fbelavenuto/colecofpga/DOCs/Cartridge/CVUNOEXP1.JPG

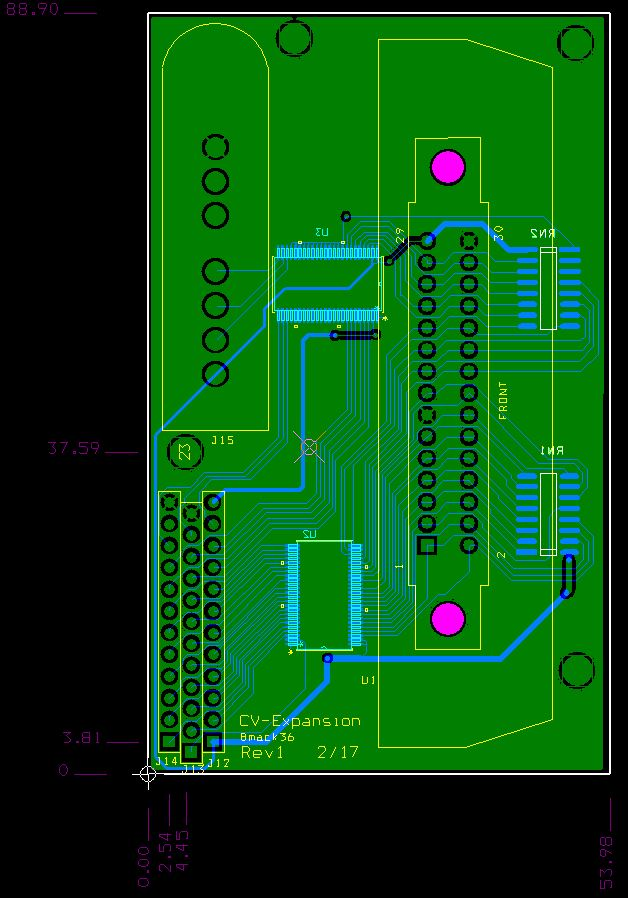
DOCs/Cartridge/CVUNOEXP1.JPG
