fbelavenuto/colecofpga/DOCs/zxuno_vga2m/SCH_VGA2M.pdf

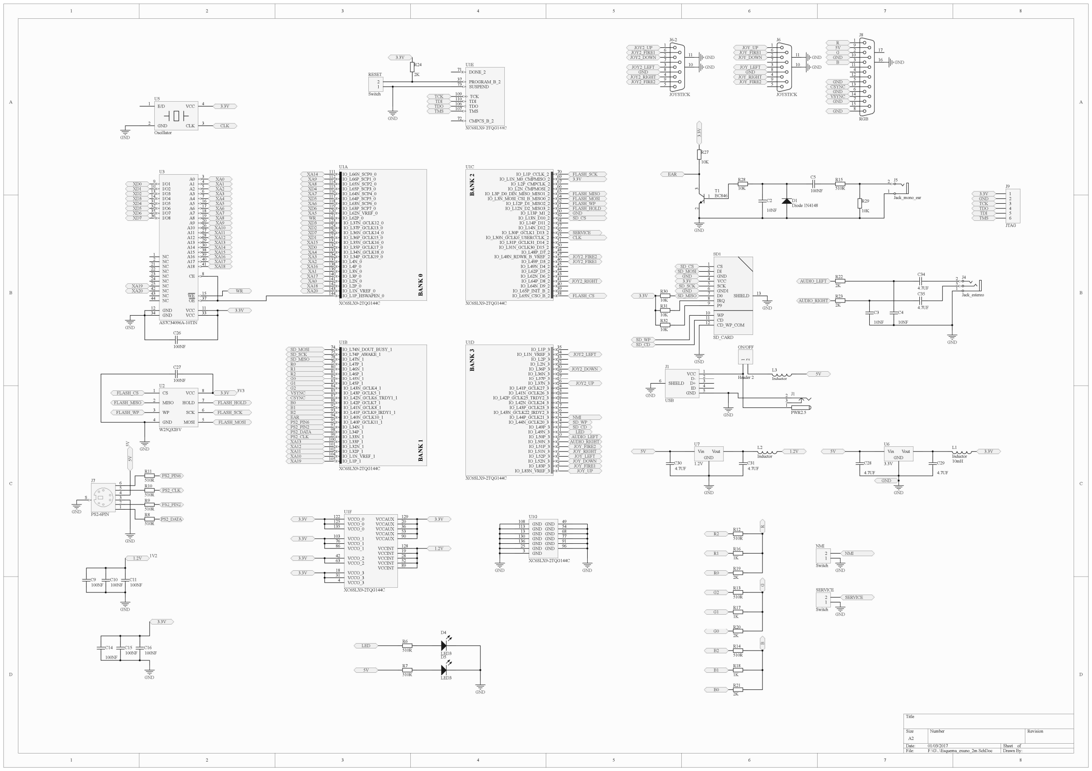
[picture p2: page 1]

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
Title

Size | Number | Revision
A2
Date: | 01/03/2017 | Sheet of
File: | F:\G\..\Esquema_zxuno_2m.SchDoc | Drawn By:
144 | IO_L1P_HSWAPEN_0 | BANK ⁰ IO_L1N_VREF_0 143 | IO_L2P_0 142 | IO_L2N_0 141 | IO_L3P_0 140 | IO_L3N_0 139 | IO_L4P_0 138 | IO_L4N_0 137 | IO_L34P_GCLK19_0 134 | IO_L34N_GCLK18_0 133 | IO_L35P_GCLK17_0 132 | IO_L35N_GCLK16_0 131 | IO_L36P_GCLK15_0 127 | IO_L36N_GCLK14_0 126 | IO_L37P_GCLK13_0 124 | IO_L37N_GCLK12_0 123 | IO_L62P_0 121 | IO_L62N_VREF_0 120 | IO_L63P_SCP7_0 119 | IO_L63N_SCP6_0 118 | IO_L64P_SCP5_0 117 | IO_L64N_SCP4_0 116 | IO_L65P_SCP3_0 115 | IO_L65N_SCP2_0 114 | IO_L66P_SCP1_0 112 | IO_L66N_SCP0_0 111

U1A

XC6SLX9-2TQG144C

105 | IO_L1P_1 | BANK ¹ IO_L1N_VREF_1 104 | IO_L32P_1 102 | IO_L32N_1 101 | IO_L33P_1 100 | IO_L33N_1 99 | IO_L34P_1 98 | IO_L34N_1 97 | IO_L40P_GCLK11_1 95 | IO_L40N_GCLK10_1 94 | IO_L41P_GCLK9_IRDY1_1 93 | IO_L41N_GCLK8_1 92 | IO_L42P_GCLK7_1 88 | IO_L42N_GCLK6_TRDY1_1 87 | IO_L43P_GCLK5_1 85 | IO_L43N_GCLK4_1 84 | IO_L45P_1 83 | IO_L45N_1 82 | IO_L46P_1 81 | IO_L46N_1 80 | IO_L47P_1 79 | IO_L47N_1 78 | IO_L74P_AWAKE_1 75 | IO_L74N_DOUT_BUSY_1 74

U1B

XC6SLX9-2TQG144C | BANK ² | IO_L1P_CCLK_2 | 70
| | IO_L1N_M0_CMPMISO_2 | 69
| | IO_L2P_CMPCLK_2 | 67
| | IO_L2N_CMPMOSI_2 | 66
| | IO_L3P_D0_DIN_MISO_MISO1_2 | 65
| | IO_L3N_MOSI_CSI_B_MISO0_2 | 64
| | IO_L12P_D1_MISO2_2 | 62
| | IO_L12N_D2_MISO3_2 | 61
| | IO_L13P_M1_2 | 60
| | IO_L13N_D10_2 | 59
| | IO_L14P_D11_2 | 58
| | IO_L14N_D12_2 | 57
| | IO_L30P_GCLK1_D13_2 | 56
| | IO_L30N_GCLK0_USERCCLK_2 | 55
| | IO_L31P_GCLK31_D14_2 | 51
| | IO_L31N_GCLK30_D15_2 | 50
| | IO_L48P_D7_2 | 48
| | IO_L48N_RDWR_B_VREF_2 | 47
| | IO_L49P_D3_2 | 46
| | IO_L49N_D4_2 | 45
| | IO_L62P_D5_2 | 44
| | IO_L62N_D6_2 | 43
| | IO_L64P_D8_2 | 41
| | IO_L64N_D9_2 | 40
| | IO_L65P_INIT_B_2 | 39
| | IO_L65N_CSO_B_2 | 38

U1C

XC6SLX9-2TQG144C BANK ³ | IO_L1P_3 | 35
IO_L1N_VREF_3 | 34
IO_L2P_3 | 33
IO_L2N_3 | 32
IO_L36P_3 | 30
IO_L36N_3 | 29
IO_L37P_3 | 27
IO_L37N_3 | 26
IO_L41P_GCLK27_3 | 24
IO_L41N_GCLK26_3 | 23
IO_L42P_GCLK25_TRDY2_3 | 22
IO_L42N_GCLK24_3 | 21
IO_L43P_GCLK23_3 | 17
IO_L43N_GCLK22_IRDY2_3 | 16
IO_L44P_GCLK21_3 | 15
IO_L44N_GCLK20_3 | 14
IO_L49P_3 | 12
IO_L49N_3 | 11
IO_L50P_3 | 10
IO_L50N_3 | 9
IO_L51P_3 | 8
IO_L51N_3 | 7
IO_L52P_3 | 6
IO_L52N_3 | 5
IO_L83P_3 | 2
IO_L83N_VREF_3 | 1

U1D

XC6SLX9-2TQG144C

PROGRAM_B_2 37

CMPCS_B_2 72

DONE_2 71

TCK 109
TDI 110
TMS 107 TDO 106

SUSPEND 73

U1E

XC6SLX9-2TQG144C

VCCAUX | 129
VCCAUX | 20
VCCAUX | 36
VCCAUX | 53
VCCAUX | 90
VCCINT | 128
VCCINT | 19
VCCINT | 28
VCCINT | 52
VCCINT | 89

VCCO_0 122
VCCO_0 125
VCCO_0 135

VCCO_1 103
VCCO_1 76
VCCO_1 86

VCCO_2 42
VCCO_2 63

VCCO_3 18
VCCO_3 31
VCCO_3 4

U1F

XC6SLX9-2TQG144C

GND 108
GND 113
GND 13
GND 130
GND 136
GND 25
GND 3
GND | 49
GND | 54
GND | 68
GND | 77
GND | 91
GND | 96

U1G

XC6SLX9-2TQG144C

A15 | 38 A14 | 30 A13 | 29 A12 | 28 A11 | 27 A10 | 26 A9 | 20 A8 | 19
WE | 15
A17 | 40
A7 | 18 A6 | 17 A5 | 16 A4 | 7
A3 | 6
A2 | 5
A1 | 4
A0 | 3
VCC | 33 GND 12
OE | 37

NC 21

I/O1 9

NC 22

I/O2 10

NC 23

I/O3 13

NC 24

I/O4 14

NC 25

I/O5 31

NC 42

I/O6 32

NC 43

I/O7 35

NC 44

GND 34

A16 | 39
VCC | 11
A18 | 41 NC 2

NC 1

CE 8

I/O8 36

U3

AS7C34096A-10TIN

E/D 1

GND 2

VCC | 4
CLK | 3

U5

Oscillator

Vin Vout
GND

U6

3.3V

Vin Vout
GND

U7

1.2V

2

1

5

J4

Jack_estereo

2

1

J5

Jack_mono_ear

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
JOYSTICK

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
PS2-6PIN

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
JTAG 1

2

ON/OFF

Header 2

1

2

RESET

Switch

D1
Diode 1N4148

D4

LED3
D5

LED3

3
1 2

T1
BC846

10mH

L1

Inductor

L2

Inductor

L3

Inductor

510R

R6

510R

R7

510R

R8

510R

R9

510R

R10

510R

R11

510R

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
10NF

C2

10NF

C3

10NF

C4

100NF

C11

100NF

C14

100NF

C26

100NF

C27

100NF

C5

100NF

C9
100NF

C10

4.7UF

C28

4.7UF

C29
4.7UF

C30
4.7UF

C31

4.7UF

C34

4.7UF

C35

FLASH_SCK

FLASH_SCK

3.3V

FLASH_MISO
FLASH_MOSI
FLASH_WP
FLASH_HOLD
GND
SD_CS

CLK

FLASH_CS

SD_MOSI
SD_SCK
SD_MISO
R0
R1
R2
G0
G1
G2
VSYNC
CSYNC
B0
B1
B2
EAR
PS2_PIN6
PS2_PIN2
PS2_DATA
PS2_CLK
XA13
XA12
XA11
XA10
XA19

XA14
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
XA15
XD0
XA4
XA3
XA2
XA16
XA1
XA17
XA0
XA18
WR | XA20

3.3V

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
XA10
XA11
XA12
XA13
XA14
XA15
XA16
XA17
XA18

XA19
XA20

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
3.3V

GND

3.3V

GND

CLK

3.3V

3.3V

GND

3.3V

3.3V

FLASH_CS

FLASH_MISO

FLASH_WP

FLASH_HOLD

FLASH_MOSI

3.3V

GND

PS2_PIN6

PS2_CLK

PS2_PIN2

PS2_DATA ⁵V

GND

1.2V

GND

100NF

C15
100NF

C16

3.3V

GND

3.3V

LED
AUDIO_LEFT
AUDIO_RIGHT
JOY_FIRE2
JOY_RIGHT
JOY_LEFT
JOY_DOWN
JOY_FIRE1
JOY_UP

1.2V

GND | GND

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
5V | 1.2V

GND

5V | 3.3V

3.3V
GND
TCK
TDO
TDI
TMS

JOY_UP

JOY_DOWN

JOY_LEFT

JOY_RIGHT

JOY_FIRE1

GND

JOY_FIRE2

SD_CS
SD_MOSI
GND
3.3V
SD_SCK
GND
3.3V | SD_MISO

GND

GND

5V

AUDIO_LEFT

AUDIO_RIGHT

GND ³.3V

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
VSYNC

CSYNC

5V

CS 1

MISO 2

WP 3

GND 4

VCC | 8
HOLD | 7
SCK | 6
MOSI | 5

U2

W25Q32BV

VCC | 1
D- | 2
D+ | 3
ID | 4
GND | 5

SHIELD 6

J1

USB

CS 1
DI 2
GND 3
VCC 4
SCK 5
GND1 6
D0 7
IRQ 8
P9 9

WP 10
CD 11
CD_WP_COM 12

SHIELD 13

SD1

SD_CARD

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
J6-2

JOYSTICK

1

2
3

J1

PWR2.5

510R

R12

510R

R13

510R

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
R G B

3V3 5V

1V2

GND

JOY2_UP
JOY2_FIRE1
JOY2_DOWN

JOY2_LEFT
GND
JOY2_RIGHT
JOY2_FIRE2

JOY2_UP

JOY2_FIRE1

JOY2_DOWN

JOY2_LEFT

JOY2_RIGHT

JOY2_FIRE2

1

2

NMI

Switch

1

2

SERVICE

Switch

NMI

NMI

GND

GND

SERVICE

SERVICE

SD_WP
SD_CD

SD_WP
SD_CD

GND

GND

GND

GND

GND

GND

GND
