fbelavenuto/colecofpga/DOCs/BIOS screen.png

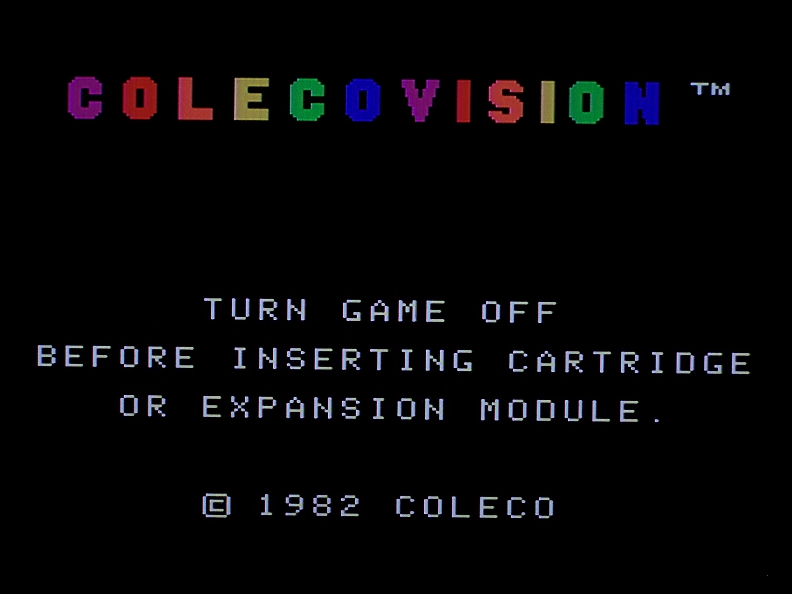
DOCs/BIOS screen.png
