fbelavenuto/colecofpga/DOCs/Cartridge/Cartridge_pinout.png

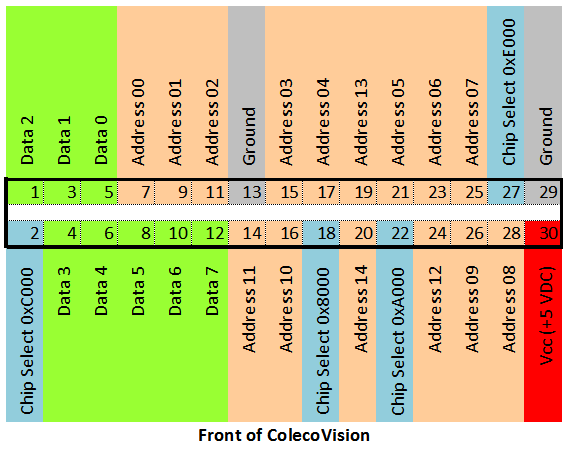
DOCs/Cartridge/Cartridge_pinout.png
