fbelavenuto/colecofpga/DOCs/ColecoController.jpg

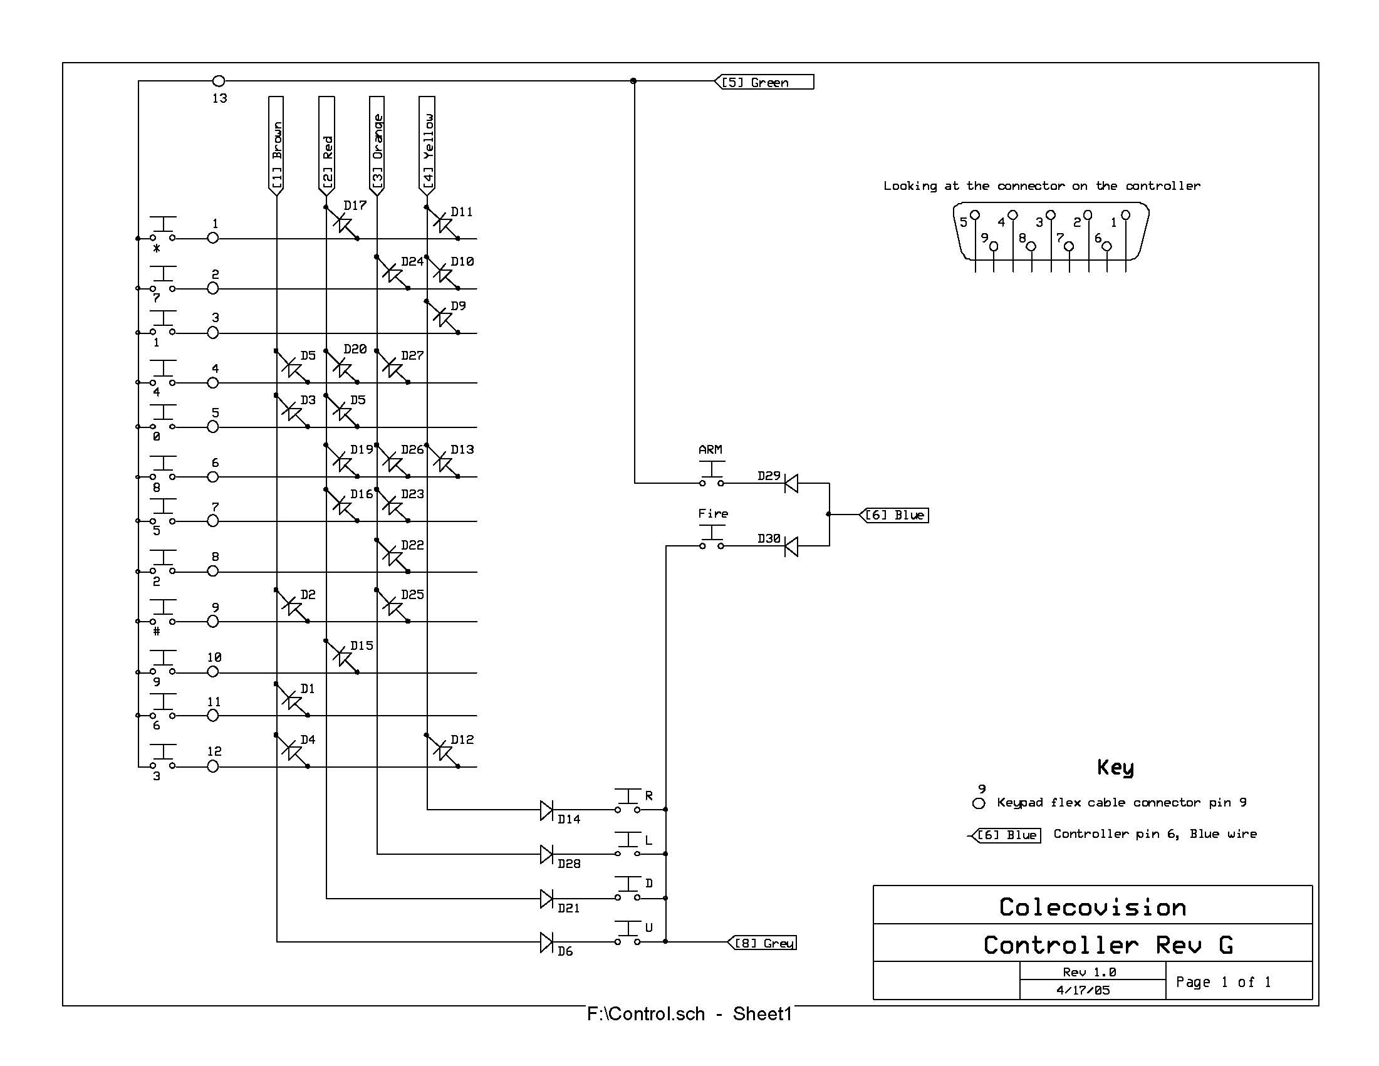
DOCs/ColecoController.jpg
