fbelavenuto/colecofpga/DOCs/SegaPad.png

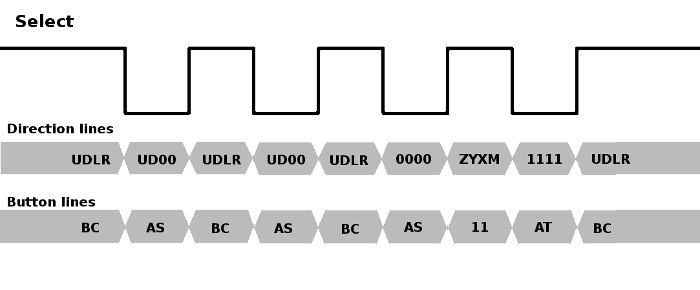
DOCs/SegaPad.png
