fbelavenuto/colecofpga/Hardware/prot2/Support/Components Map(bottom).png

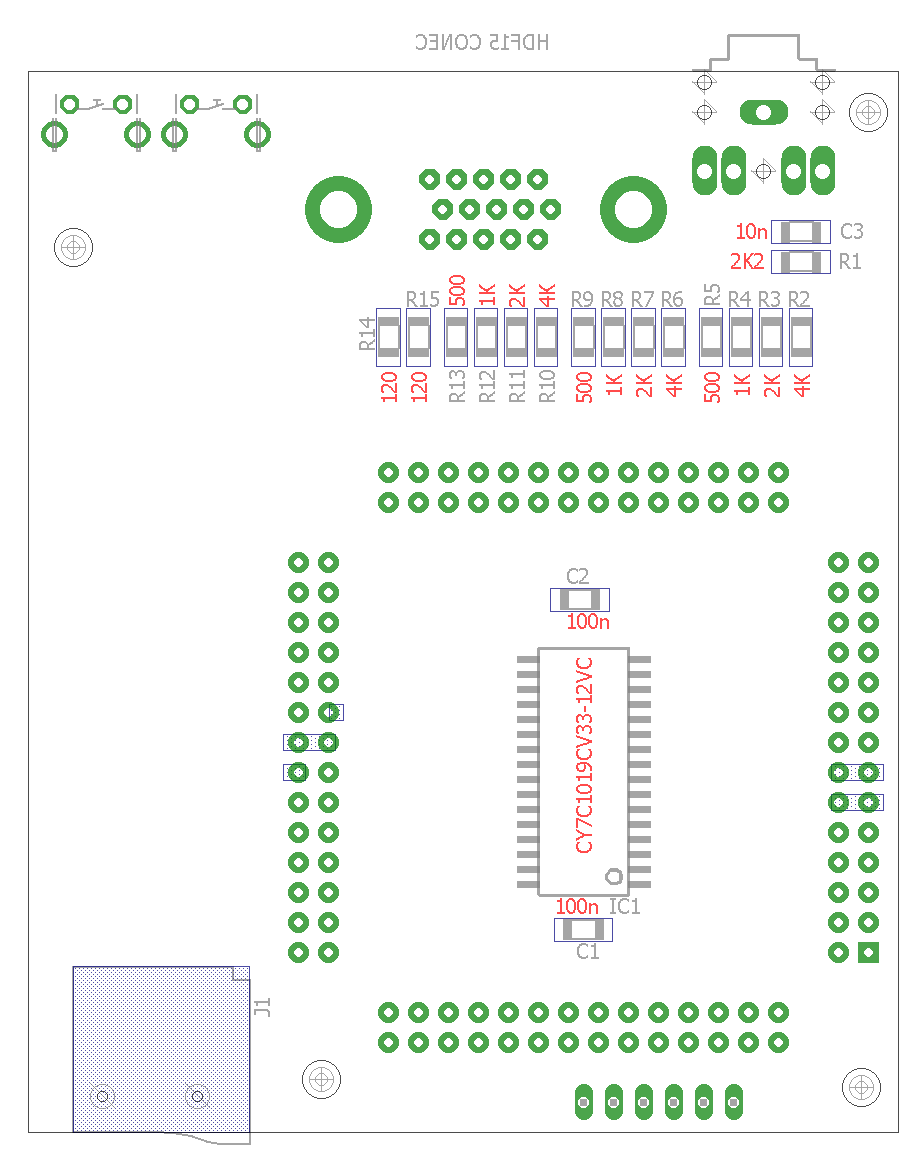
Hardware/prot2/Support/Components Map(bottom).png
