fbelavenuto/colecofpga/Hardware/prot2/Support/Components Map(top).png

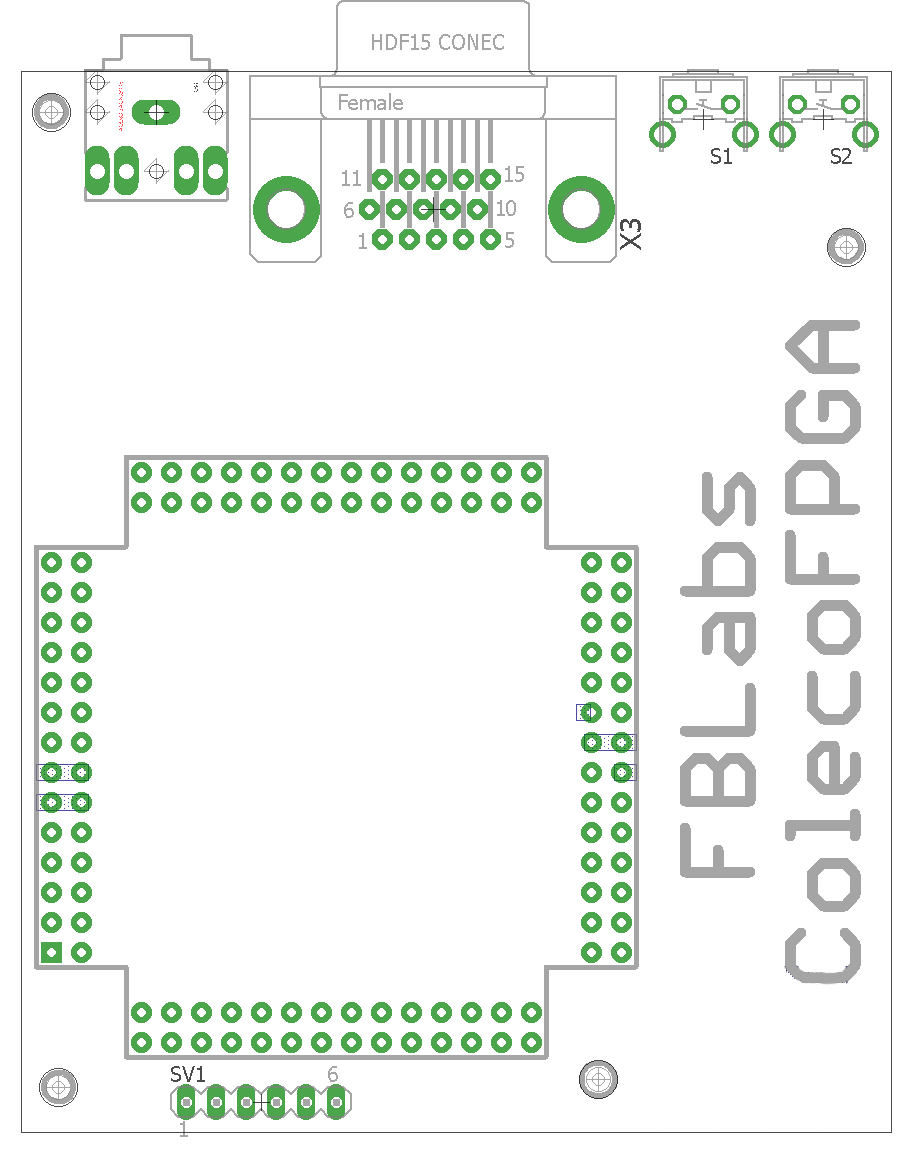
Hardware/prot2/Support/Components Map(top).png
