fbelavenuto/colecofpga/(threads)

Thread 2 (2018-11-06):

Bug in the Noise Generator (FABF)

fbelavenuto, 2018-11-06:
I’ve found a bug in the ColecoFPGA using my friend homebrew game : “battle of hoth”
https://www.youtube.com/watch?v=SUFYieaRjvY

The noise generator seem not working and “use the force” is not played.
To help debuging he provide me a rom file playing “use the force” all the time.

It would be great if you could fixe this issue because lot of hombrew use the noise generator.

Regards
Fabrice

Thread 3 (2022-06-14):

cannot compile multicrt rom

rampa069, 2022-06-14:
I am doing some changes to the coleco FPGA core (changes SN, added AY and 32Kram for SGM, etc)

 I want to recompile the rom (need to silence AY on boot) but seems there are problems compiling.

 Whith modern sdcc (4.2.0)  i have added --sdcccall 0 to makefile and the cartridge boots. but cannot mount the SD. are the sources the same version as the .rom file? if they are the same, do you remember which sdcc version you used to compile?

Thanks in advance!

rampa069, 2022-06-14:
found it. it works with 3.8.0....

Closed 2022-06-14.
