fbelavenuto/colecofpga/DOCs/colecovision.pdf

1

2

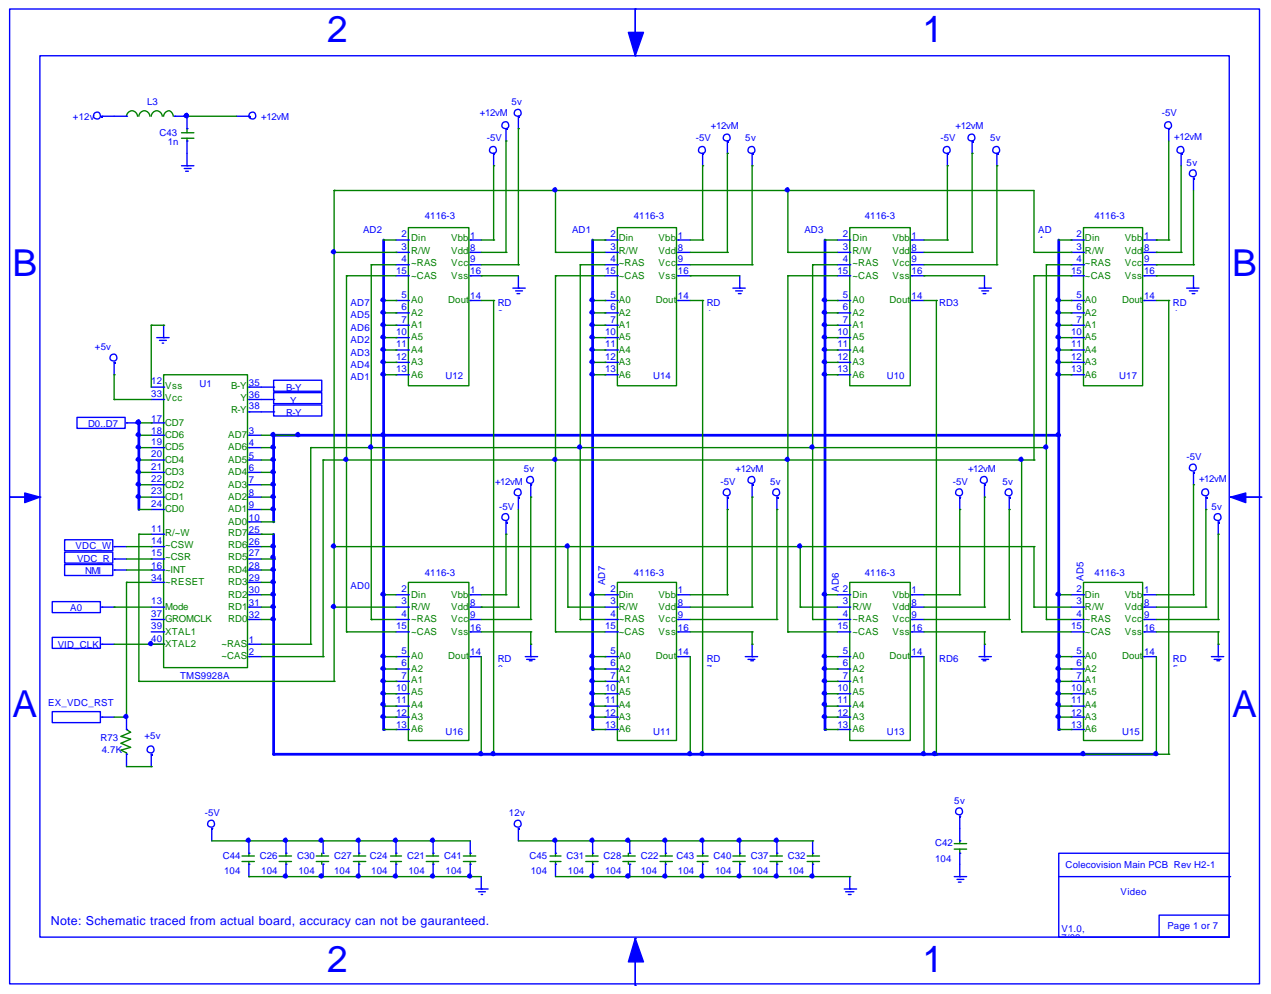
[picture p9: page 1]

Colecovision Main PCB Rev H2-1

1

2

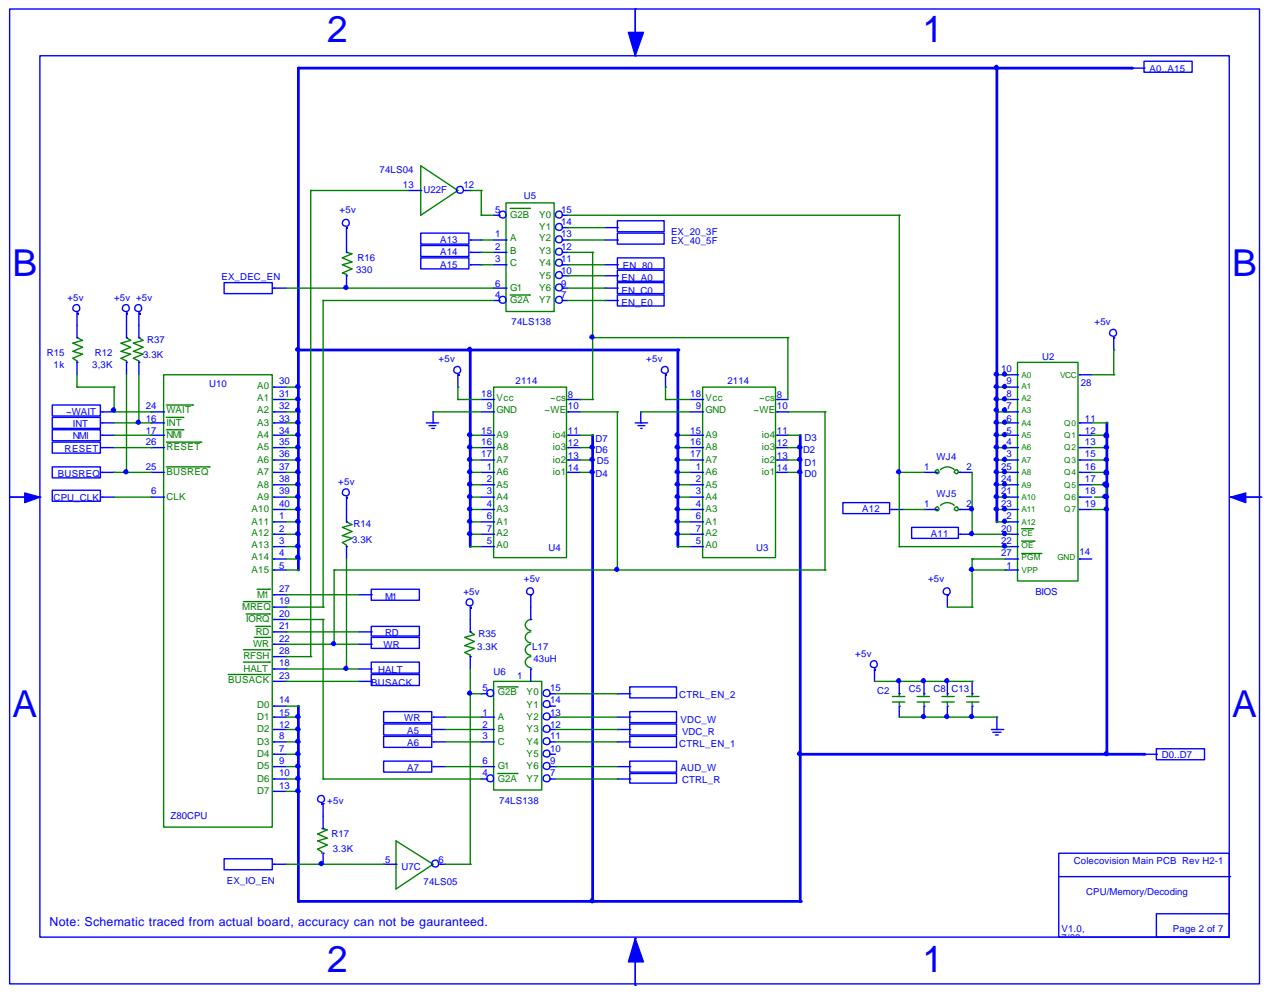
[picture p10: page 2]

Colecovision Main PCB Rev H2-1

1

2

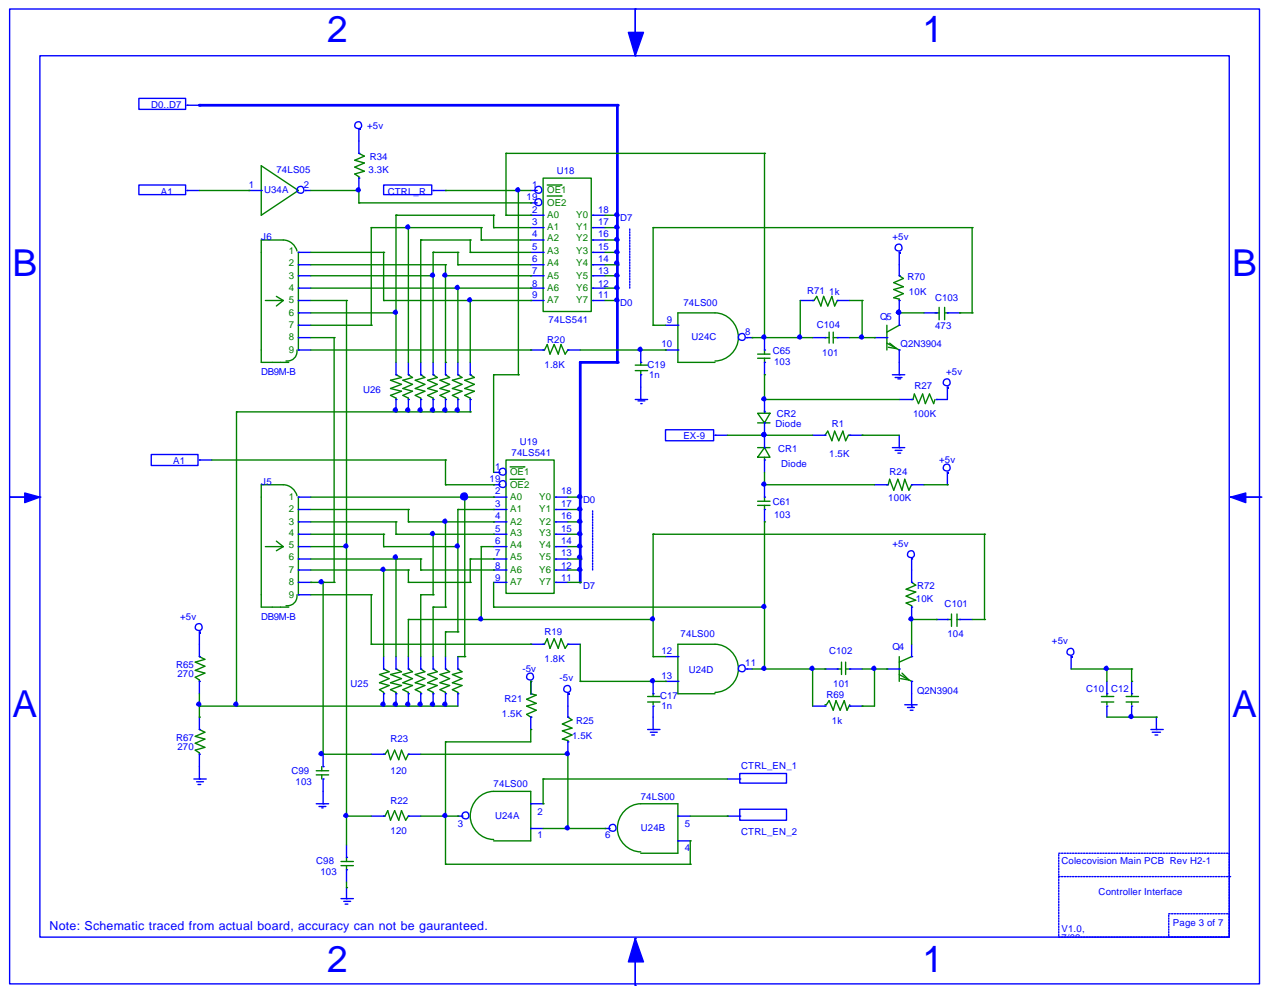
[picture p11: page 3]

Colecovision Main PCB Rev H2-1

Note: Schematic traced from actual board, accuracy can not be gauranteed.

1

2

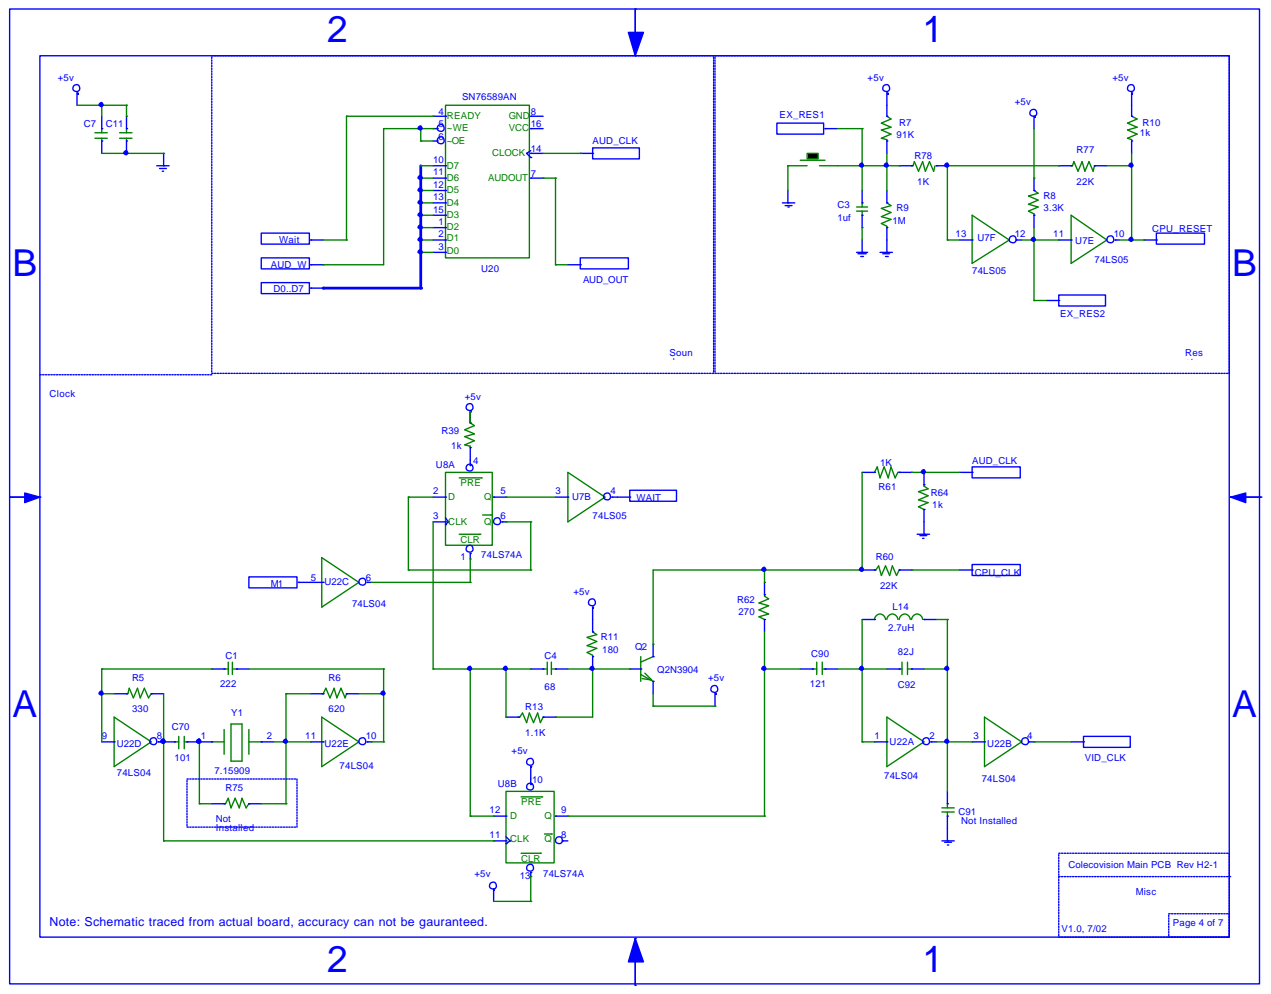
[picture p12: page 4]

Colecovision Main PCB Rev H2-1

1

2

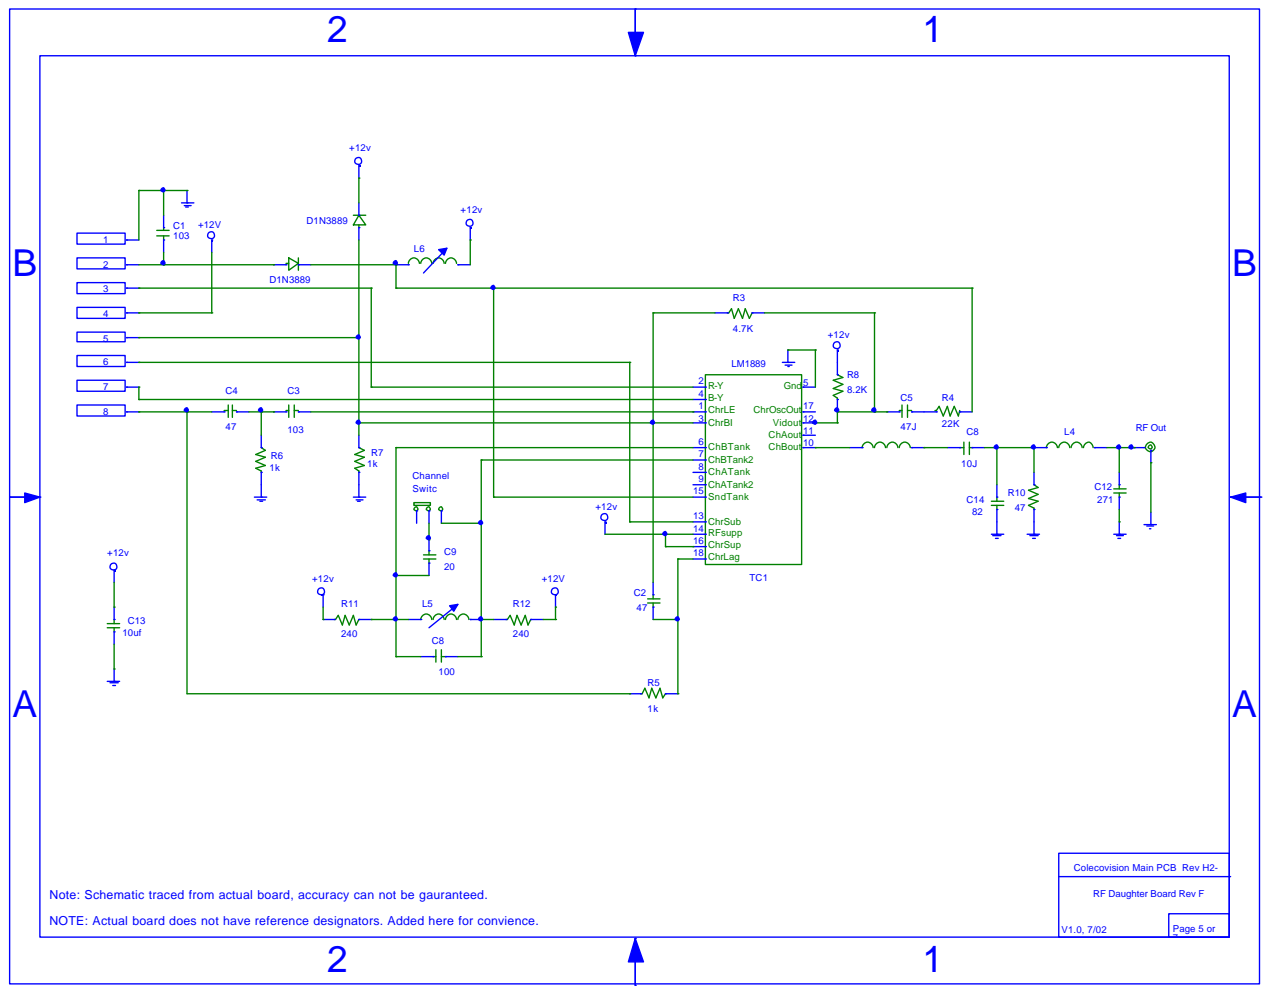
[picture p13: page 5]

Colecovision Main PCB Rev H2-
RF Daughter Board Rev F

Note: Schematic traced from actual board, accuracy can not be gauranteed.

NOTE: Actual board does not have reference designators. Added here for convience.

1

2

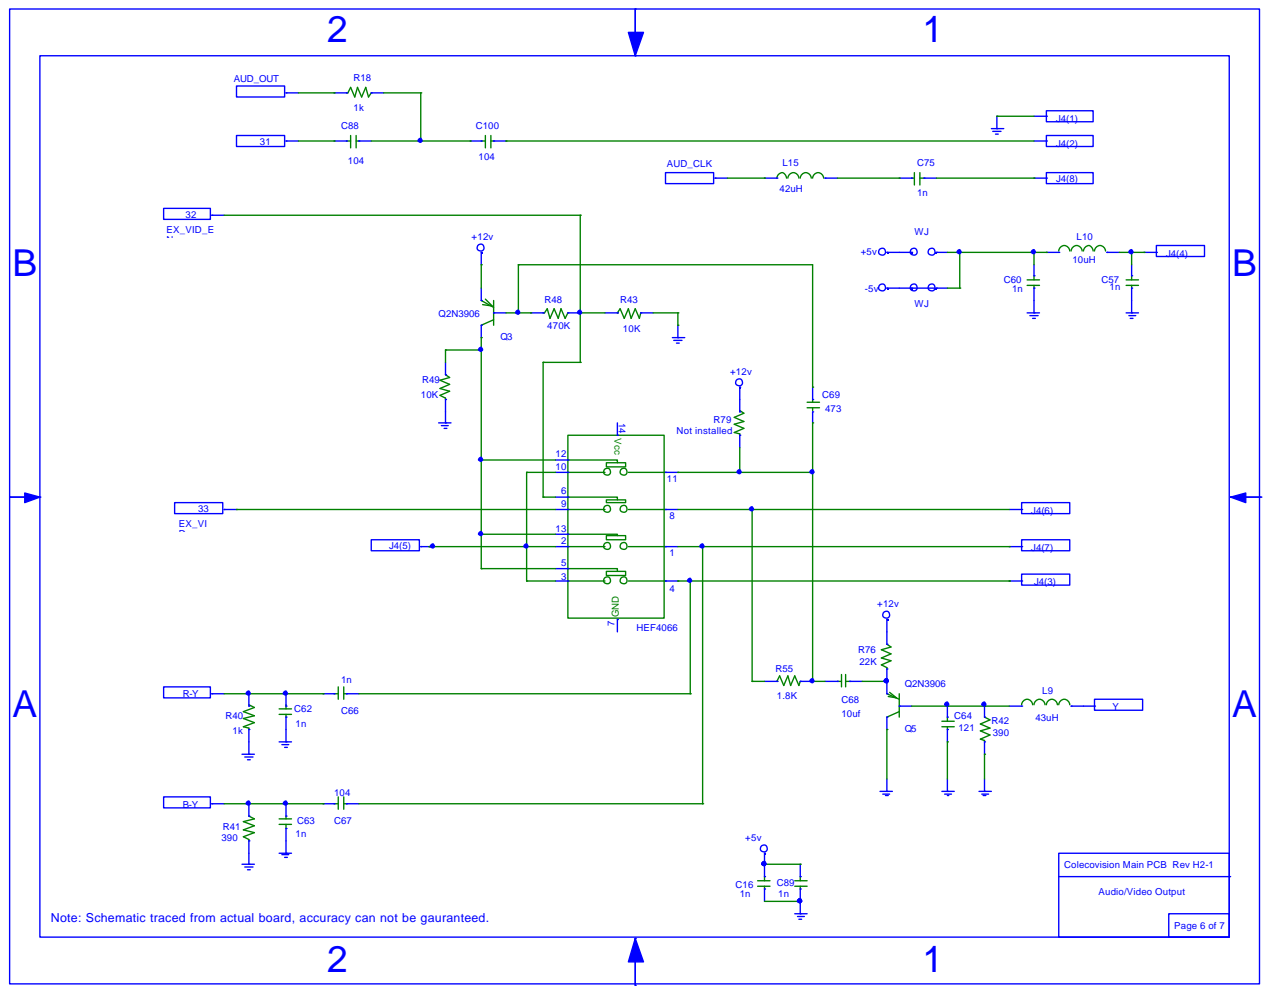
[picture p14: page 6]

Colecovision Main PCB Rev H2-1

Note: Schematic traced from actual board, accuracy can not be gauranteed.

1

2

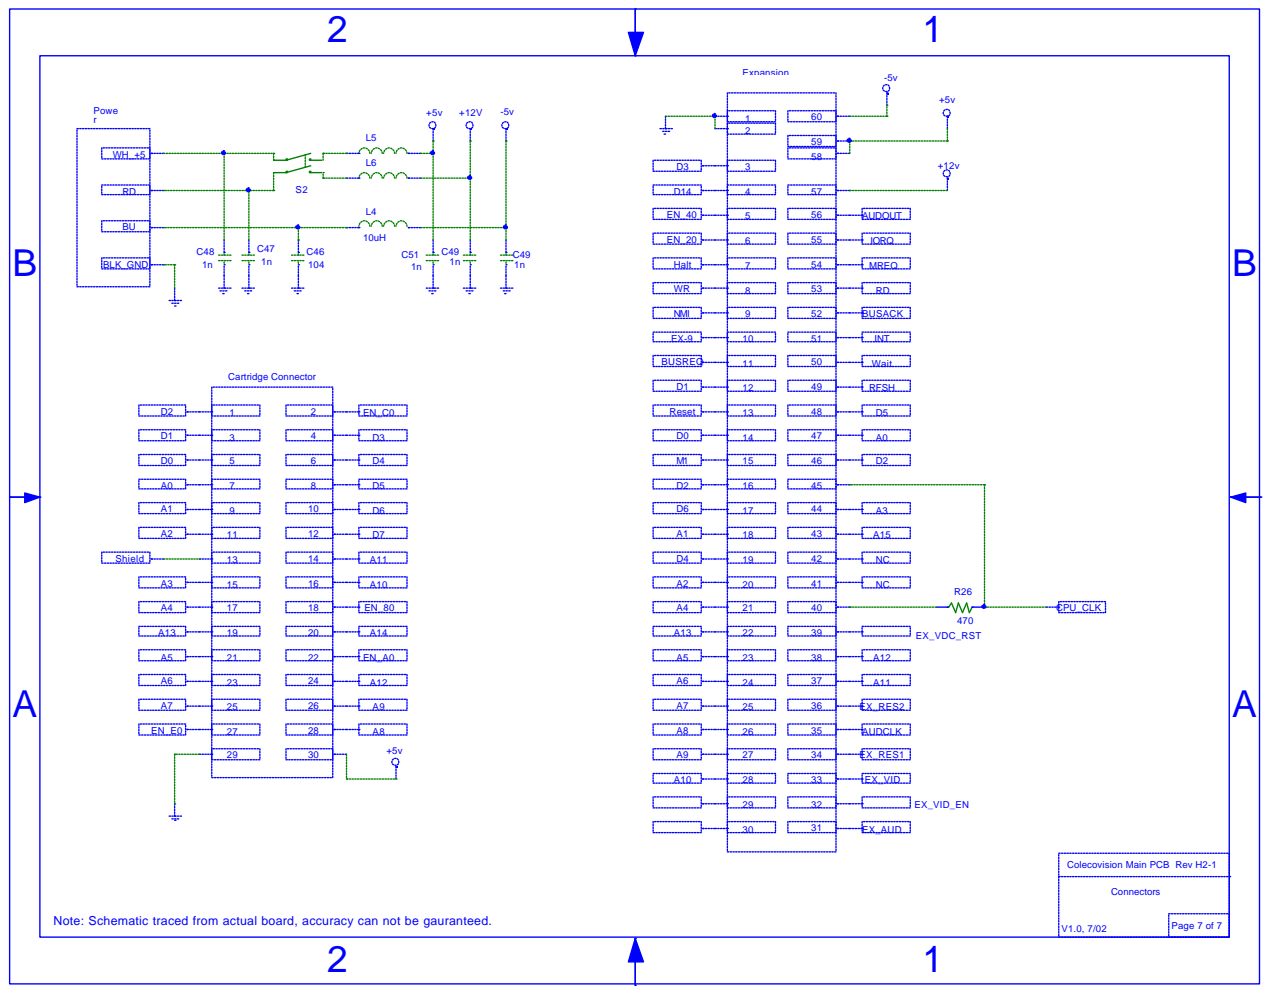
[picture p15: page 7]

Colecovision Main PCB Rev H2-1
