fbelavenuto/colecofpga/Hardware/prot2/Eagle/colecovision2.brd

## EAGLE design Hardware/prot2/Eagle/colecovision2.brd (2016-09-15)

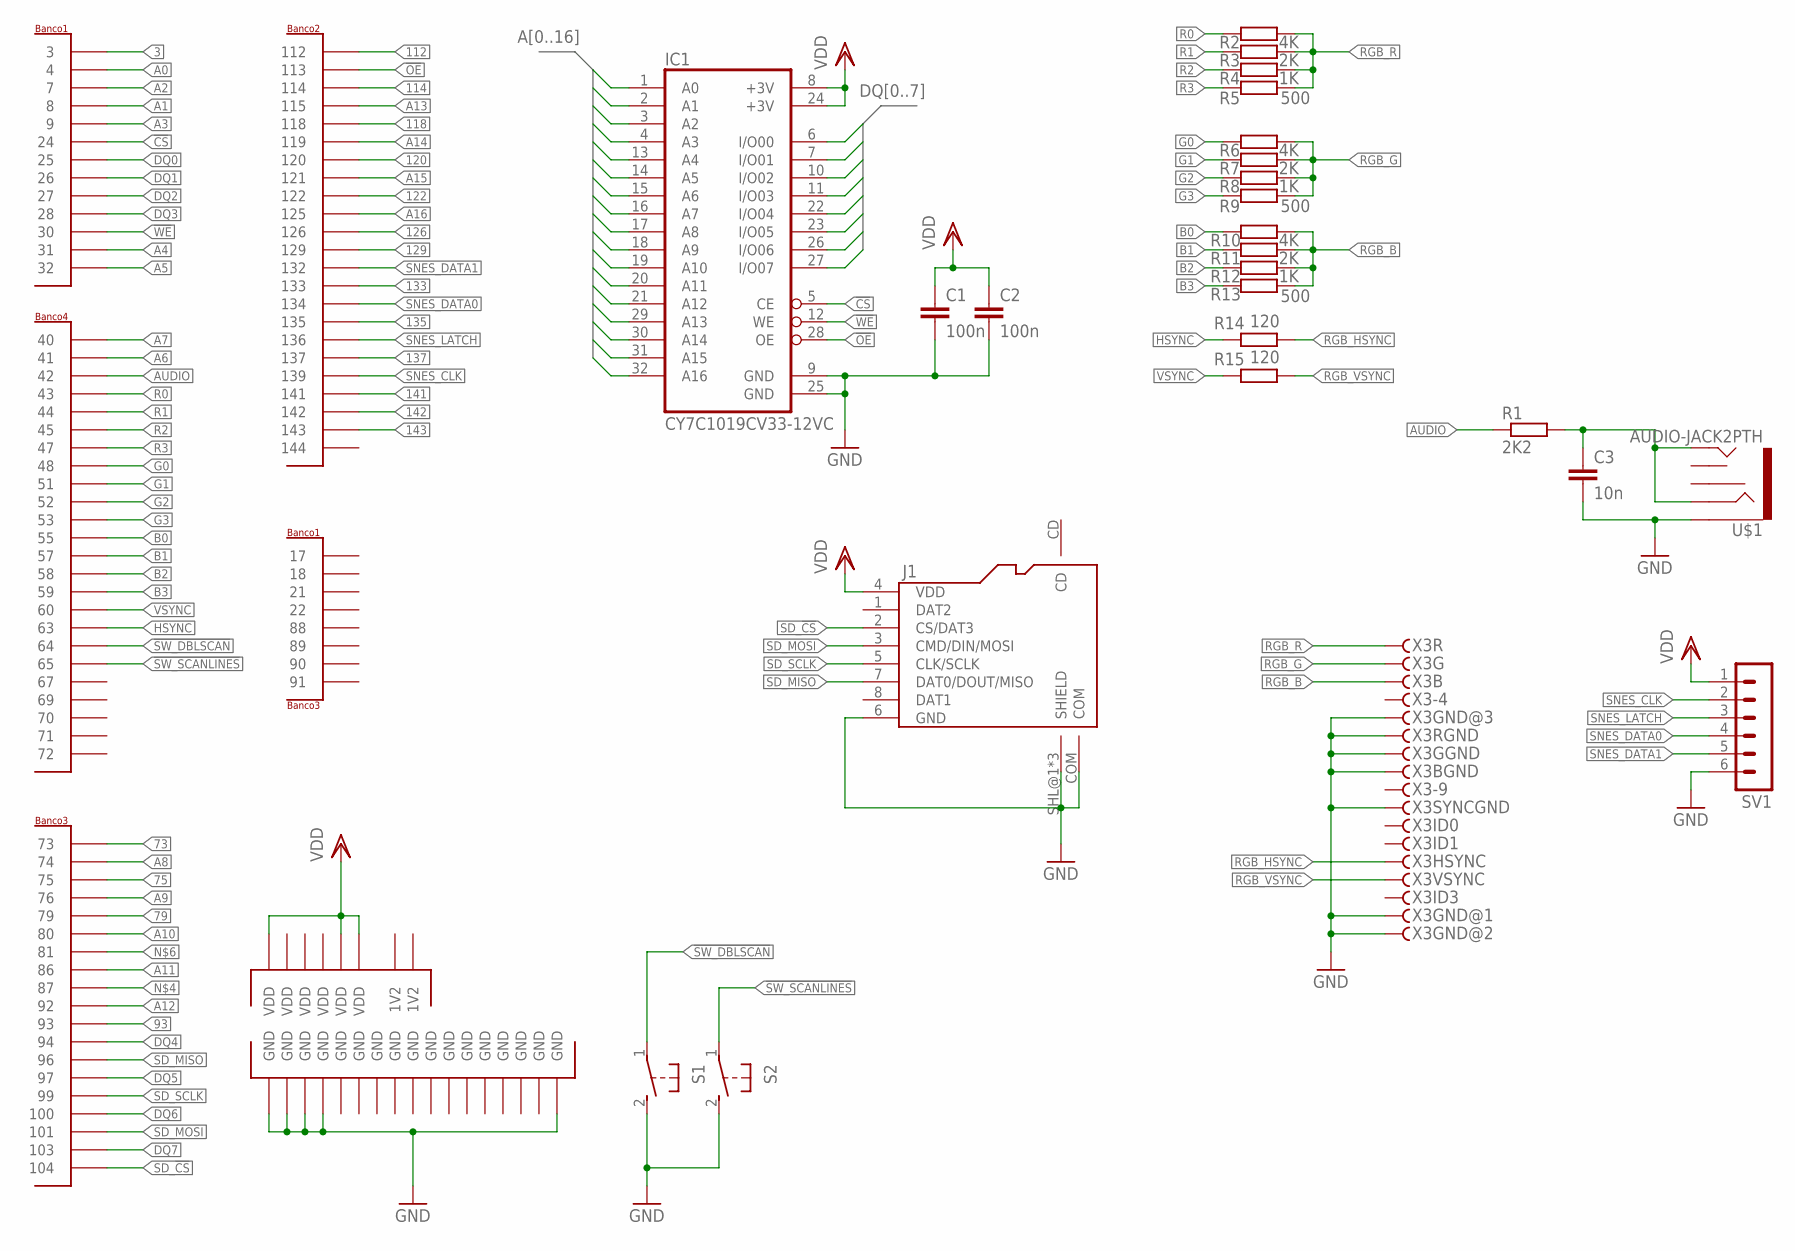
[picture p16: schematic colecovision2.sch]

Parts:
C1, C2: 100n; C1206
C3: 10n; C1206
IC1: CY7C1019CV33-12VC; SOJ32-400
J1: MICROSD-9P; 9P-SMD-W/-RING
PLC1: PLACAEP2C5LASER; 4X28_LASER
R1: 2K2; R1206
R2, R6, R10: 4K; R1206
R3, R7, R11: 2K; R1206
R4, R8, R12: 1K; R1206
R5, R9, R13: 500; R1206
R14, R15: 120; R1206
S1, S2: 31-XX; B3F-31XX
SV1: MA06-1
U$1: AUDIO-JACK2PTH; AUDIO-JACK
X3: VGAH; HDF15H

Connections:
1V2: PLC1.P$19 (1V2), PLC1.P$20 (1V2)
3: PLC1.P$3 (3)
73: PLC1.P$59 (73)
75: PLC1.P$61 (75)
79: PLC1.P$63 (79)
93: PLC1.P$73 (93)
112: PLC1.P$87 (112)
114: PLC1.P$89 (114)
118: PLC1.P$91 (118)
120: PLC1.P$93 (120)
122: PLC1.P$95 (122)
126: PLC1.P$97 (126)
129: PLC1.P$98 (129)
133: PLC1.P$100 (133)
135: PLC1.P$102 (135)
137: PLC1.P$104 (137)
141: PLC1.P$106 (141)
142: PLC1.P$107 (142)
143: PLC1.P$108 (143)
!CS: IC1.5 (CE), PLC1.P$16 (24)
!OE: IC1.28 (OE), PLC1.P$88 (113)
!SW_DBLSCAN: PLC1.P$46 (64), S1.1
!SW_SCANLINES: PLC1.P$47 (65), S2.1
!WE: IC1.12 (WE), PLC1.P$21 (30)
A0: IC1.1 (A0), PLC1.P$4 (4)
A1: IC1.2 (A1), PLC1.P$6 (8)
A2: IC1.3 (A2), PLC1.P$5 (7)
A3: IC1.4 (A3), PLC1.P$7 (9)
A4: IC1.13 (A4), PLC1.P$24 (31)
A5: IC1.14 (A5), PLC1.P$23 (32)
A6: IC1.15 (A6), PLC1.P$30 (41)
A7: IC1.16 (A7), PLC1.P$29 (40)
A8: IC1.17 (A8), PLC1.P$60 (74)
A9: IC1.18 (A9), PLC1.P$62 (76)
A10: IC1.19 (A10), PLC1.P$64 (80)
A11: IC1.20 (A11), PLC1.P$66 (86)
A12: IC1.21 (A12), PLC1.P$72 (92)
A13: IC1.29 (A13), PLC1.P$90 (115)
A14: IC1.30 (A14), PLC1.P$92 (119)
A15: IC1.31 (A15), PLC1.P$94 (121)
A16: IC1.32 (A16), PLC1.P$96 (125)
AUDIO: PLC1.P$31 (42), R1.1
B0: PLC1.P$40 (55), R10.1
B1: PLC1.P$41 (57), R11.1
B2: PLC1.P$42 (58), R12.1
B3: PLC1.P$43 (59), R13.1
DQ0: IC1.6 (I/O00), PLC1.P$15 (25)
DQ1: IC1.7 (I/O01), PLC1.P$18 (26)
DQ2: IC1.10 (I/O02), PLC1.P$17 (27)
DQ3: IC1.11 (I/O03), PLC1.P$22 (28)
DQ4: IC1.22 (I/O04), PLC1.P$74 (94)
DQ5: IC1.23 (I/O05), PLC1.P$76 (97)
DQ6: IC1.26 (I/O06), PLC1.P$78 (100)
DQ7: IC1.27 (I/O07), PLC1.P$80 (103)
G0: PLC1.P$36 (48), R6.1
G1: PLC1.P$37 (51), R7.1
G2: PLC1.P$38 (52), R8.1
G3: PLC1.P$39 (53), R9.1
GND: C1.2, C2.2, C3.2, IC1.9 (GND), IC1.25 (GND), J1.6 (GND), J1.COM, J1.SHL@1 (SHIELD), J1.SHL@2 (SHIELD), J1.SHL@3 (SHIELD), PLC1.P$1 (GND), PLC1.P$2 (GND), PLC1.P$8 (GND), PLC1.P$9 (GND), PLC1.P$10 (GND), PLC1.P$25 (GND), PLC1.P$26 (GND), PLC1.P$53 (GND), PLC1.P$54 (GND), PLC1.P$57 (GND), PLC1.P$58 (GND), PLC1.P$82 (GND), PLC1.P$83 (GND), PLC1.P$85 (GND), PLC1.P$86 (GND), PLC1.P$110 (GND), PLC1.P$111 (GND), S1.2 (S), S2.2 (S), SV1.6, U$1.SLEEVE, X3.5, X3.6, X3.7, X3.8, X3.10, X3.GND@1, X3.GND@2
HSYNC: PLC1.P$45 (63), R14.1
unnamed: C3.1, R1.2, U$1.RING, U$1.TIP
R0: PLC1.P$32 (43), R2.1
R1: PLC1.P$33 (44), R3.1
R2: PLC1.P$34 (45), R4.1
R3: PLC1.P$35 (47), R5.1
RGB_B: R10.2, R11.2, R12.2, R13.2, X3.3
RGB_G: R6.2, R7.2, R8.2, R9.2, X3.2
RGB_HSYNC: R14.2, X3.13
RGB_R: R2.2, R3.2, R4.2, R5.2, X3.1
RGB_VSYNC: R15.2, X3.14
SD_!CS: J1.2 (CS/DAT3), PLC1.P$81 (104)
SD_MISO: J1.7 (DAT0/DOUT/MISO), PLC1.P$75 (96)
SD_MOSI: J1.3 (CMD/DIN/MOSI), PLC1.P$79 (101)
SD_SCLK: J1.5 (CLK/SCLK), PLC1.P$77 (99)
SNES_CLK: PLC1.P$105 (139), SV1.2
SNES_DATA0: PLC1.P$101 (134), SV1.4
SNES_DATA1: PLC1.P$99 (132), SV1.5
SNES_LATCH: PLC1.P$103 (136), SV1.3
VDD: C1.1, C2.1, IC1.8 (+3V), IC1.24 (+3V), J1.4 (VDD), PLC1.P$27 (VDD), PLC1.P$28 (VDD), PLC1.P$55 (VDD), PLC1.P$56 (VDD), PLC1.P$84 (VDD), PLC1.P$112 (VDD), SV1.1
VSYNC: PLC1.P$44 (60), R15.1

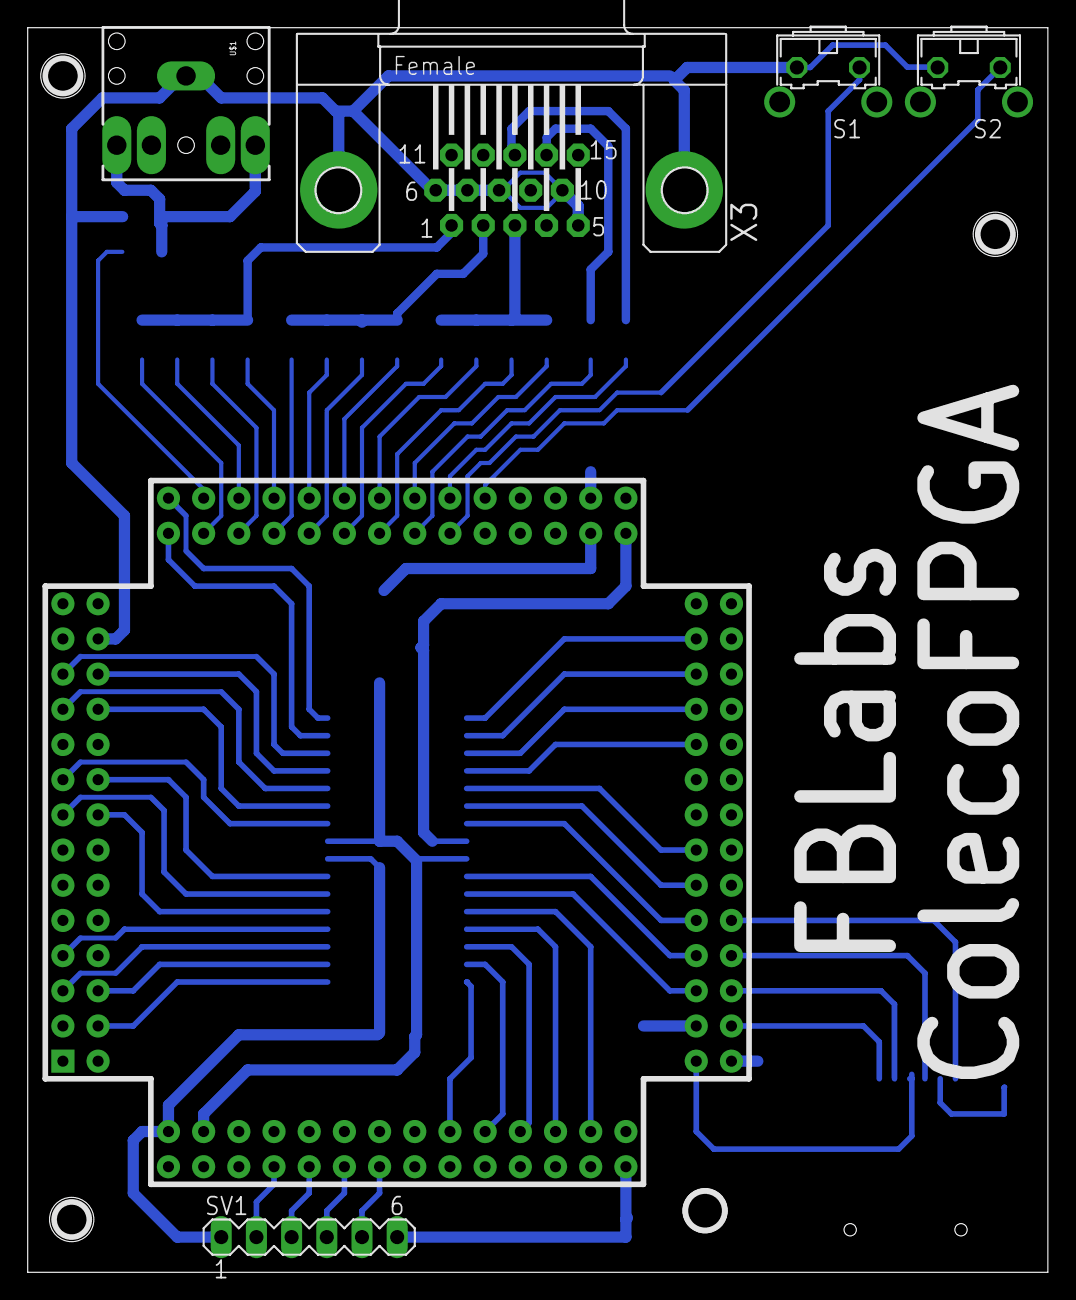
[picture p17: board colecovision2.brd from above]

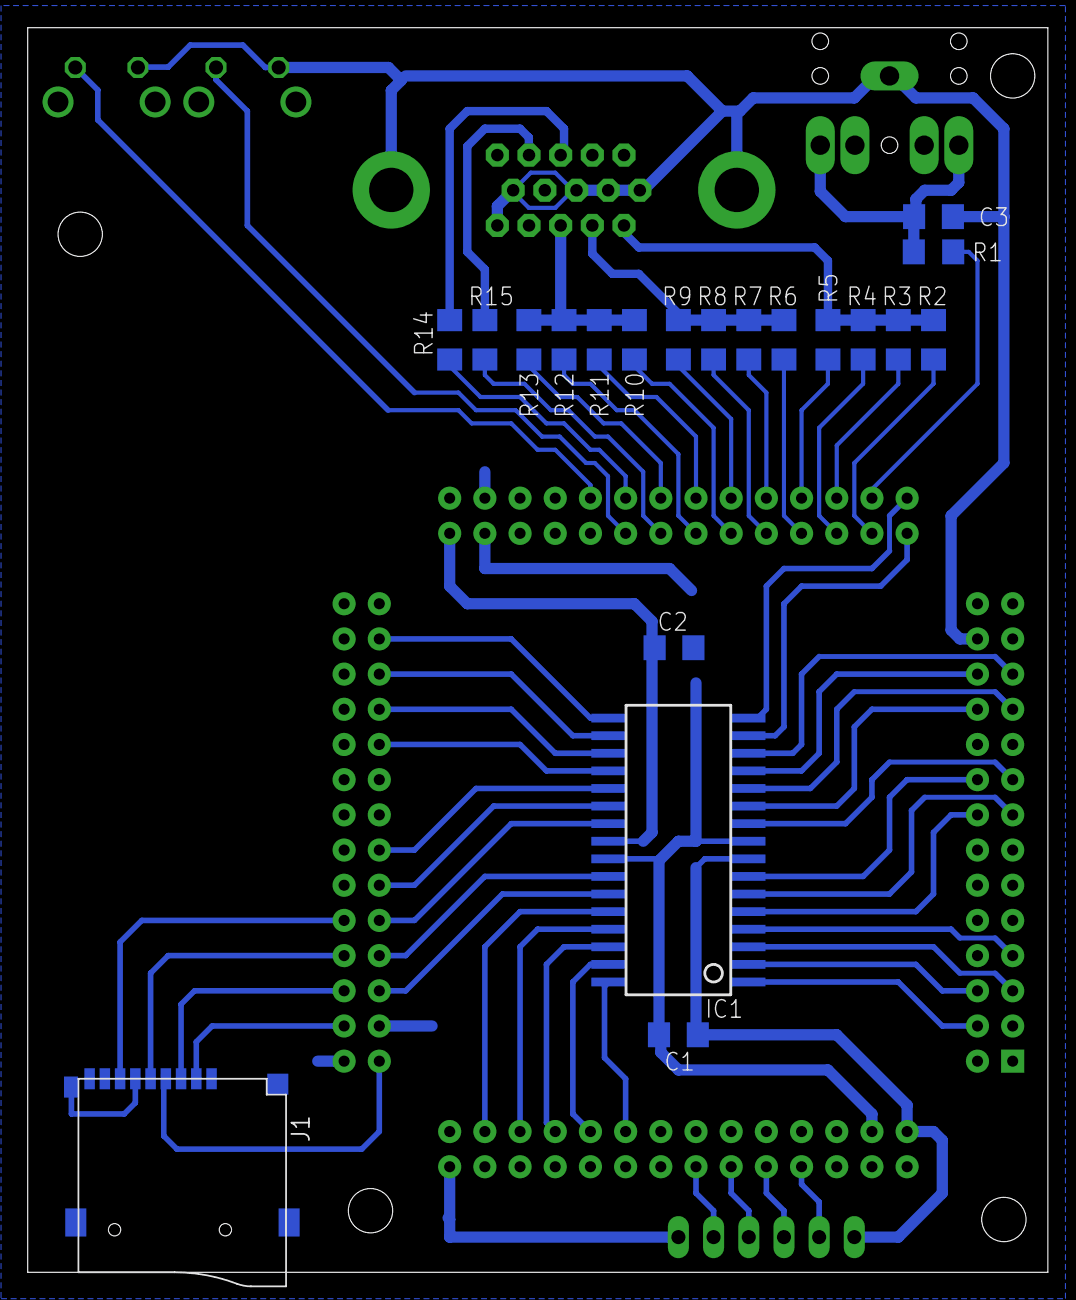
[picture p18: board colecovision2.brd from below]

Board: 3 copper layers, 73.6 x 89.8 mm, 26 parts (20 on the bottom side), 62 nets.
