fbelavenuto/colecofpga/src/rom/loaderrom.vhd

-- generated with romgen v3.0 by MikeJ
library ieee;
  use ieee.std_logic_1164.all;
  use ieee.std_logic_unsigned.all;
  use ieee.numeric_std.all;

entity loaderrom is
  port (
    CLK         : in    std_logic;
    ADDR        : in    std_logic_vector(12 downto 0);
    DATA        : out   std_logic_vector(7 downto 0)
    );
end;

architecture RTL of loaderrom is


  type ROM_ARRAY is array(0 to 8191) of std_logic_vector(7 downto 0);
  constant ROM : ROM_ARRAY := (
    x"F3",x"ED",x"56",x"C3",x"80",x"00",x"FF",x"FF", -- 0x0000
    x"ED",x"4D",x"FF",x"FF",x"FF",x"FF",x"FF",x"FF", -- 0x0008
    x"ED",x"4D",x"FF",x"FF",x"FF",x"FF",x"FF",x"FF", -- 0x0010
    x"ED",x"4D",x"FF",x"FF",x"FF",x"FF",x"FF",x"FF", -- 0x0018
    x"ED",x"4D",x"FF",x"FF",x"FF",x"FF",x"FF",x"FF", -- 0x0020
    x"ED",x"4D",x"FF",x"FF",x"FF",x"FF",x"FF",x"FF", -- 0x0028
    x"ED",x"4D",x"FF",x"FF",x"FF",x"FF",x"FF",x"FF", -- 0x0030
    x"ED",x"4D",x"FF",x"FF",x"FF",x"FF",x"FF",x"FF", -- 0x0038
    x"FF",x"FF",x"FF",x"FF",x"FF",x"FF",x"FF",x"FF", -- 0x0040
    x"FF",x"FF",x"FF",x"FF",x"FF",x"FF",x"FF",x"FF", -- 0x0048
    x"FF",x"FF",x"FF",x"FF",x"FF",x"FF",x"FF",x"FF", -- 0x0050
    x"FF",x"FF",x"FF",x"FF",x"FF",x"FF",x"FF",x"FF", -- 0x0058
    x"FF",x"FF",x"FF",x"FF",x"FF",x"FF",x"ED",x"45", -- 0x0060
    x"FF",x"FF",x"FF",x"FF",x"FF",x"FF",x"FF",x"FF", -- 0x0068
    x"FF",x"FF",x"FF",x"FF",x"FF",x"FF",x"FF",x"FF", -- 0x0070
    x"FF",x"FF",x"FF",x"FF",x"FF",x"FF",x"FF",x"FF", -- 0x0078
    x"31",x"FF",x"7F",x"CD",x"7D",x"1D",x"CD",x"DA", -- 0x0080
    x"01",x"C3",x"00",x"01",x"FF",x"FF",x"FF",x"FF", -- 0x0088
    x"FF",x"FF",x"FF",x"FF",x"FF",x"FF",x"FF",x"FF", -- 0x0090
    x"FF",x"FF",x"FF",x"FF",x"FF",x"FF",x"FF",x"FF", -- 0x0098
    x"FF",x"FF",x"FF",x"FF",x"FF",x"FF",x"FF",x"FF", -- 0x00A0
    x"FF",x"FF",x"FF",x"FF",x"FF",x"FF",x"FF",x"FF", -- 0x00A8
    x"FF",x"FF",x"FF",x"FF",x"FF",x"FF",x"FF",x"FF", -- 0x00B0
    x"FF",x"FF",x"FF",x"FF",x"FF",x"FF",x"FF",x"FF", -- 0x00B8
    x"FF",x"FF",x"FF",x"FF",x"FF",x"FF",x"FF",x"FF", -- 0x00C0
    x"FF",x"FF",x"FF",x"FF",x"FF",x"FF",x"FF",x"FF", -- 0x00C8
    x"FF",x"FF",x"FF",x"FF",x"FF",x"FF",x"FF",x"FF", -- 0x00D0
    x"FF",x"FF",x"FF",x"FF",x"FF",x"FF",x"FF",x"FF", -- 0x00D8
    x"FF",x"FF",x"FF",x"FF",x"FF",x"FF",x"FF",x"FF", -- 0x00E0
    x"FF",x"FF",x"FF",x"FF",x"FF",x"FF",x"FF",x"FF", -- 0x00E8
    x"FF",x"FF",x"FF",x"FF",x"FF",x"FF",x"FF",x"FF", -- 0x00F0
    x"FF",x"FF",x"FF",x"FF",x"FF",x"FF",x"FF",x"FF", -- 0x00F8
    x"76",x"18",x"FD",x"21",x"03",x"00",x"39",x"4E", -- 0x0100
    x"23",x"46",x"C5",x"CD",x"D5",x"1B",x"F1",x"CB", -- 0x0108
    x"3C",x"CB",x"1D",x"4D",x"3E",x"10",x"91",x"47", -- 0x0110
    x"21",x"02",x"00",x"39",x"7E",x"F5",x"33",x"C5", -- 0x0118
    x"33",x"CD",x"47",x"0A",x"F1",x"21",x"03",x"00", -- 0x0120
    x"39",x"4E",x"23",x"46",x"C5",x"CD",x"13",x"0B", -- 0x0128
    x"F1",x"C9",x"43",x"4F",x"4C",x"45",x"43",x"4F", -- 0x0130
    x"20",x"20",x"42",x"49",x"4F",x"00",x"4F",x"4E", -- 0x0138
    x"59",x"58",x"20",x"20",x"20",x"20",x"42",x"49", -- 0x0140
    x"4F",x"00",x"53",x"50",x"4C",x"49",x"43",x"45", -- 0x0148
    x"20",x"20",x"42",x"49",x"4F",x"00",x"20",x"20", -- 0x0150
    x"20",x"20",x"20",x"20",x"43",x"4F",x"4C",x"45", -- 0x0158
    x"43",x"4F",x"56",x"49",x"53",x"49",x"4F",x"4E", -- 0x0160
    x"20",x"4C",x"4F",x"41",x"44",x"45",x"52",x"20", -- 0x0168
    x"20",x"20",x"20",x"20",x"20",x"20",x"00",x"3E", -- 0x0170
    x"FF",x"D3",x"50",x"11",x"01",x"0F",x"D5",x"3E", -- 0x0178
    x"06",x"F5",x"33",x"CD",x"C7",x"09",x"F1",x"33", -- 0x0180
    x"C1",x"E1",x"E5",x"C5",x"E5",x"3E",x"0C",x"F5", -- 0x0188
    x"33",x"CD",x"03",x"01",x"F1",x"33",x"18",x"FE", -- 0x0190
    x"21",x"00",x"71",x"36",x"3E",x"2E",x"01",x"36", -- 0x0198
    x"02",x"2E",x"02",x"36",x"D3",x"2E",x"03",x"36", -- 0x01A0
    x"42",x"2E",x"04",x"36",x"C3",x"2E",x"05",x"36", -- 0x01A8
    x"00",x"2E",x"06",x"36",x"00",x"C3",x"00",x"71", -- 0x01B0
    x"C9",x"21",x"00",x"71",x"36",x"3E",x"2E",x"01", -- 0x01B8
    x"36",x"04",x"2E",x"02",x"36",x"D3",x"2E",x"03", -- 0x01C0
    x"36",x"42",x"2E",x"04",x"36",x"C3",x"2E",x"05", -- 0x01C8
    x"36",x"00",x"2E",x"06",x"36",x"00",x"C3",x"00", -- 0x01D0
    x"71",x"C9",x"21",x"C9",x"FF",x"39",x"F9",x"DB", -- 0x01D8
    x"43",x"FD",x"21",x"00",x"60",x"FD",x"77",x"00", -- 0x01E0
    x"FD",x"7E",x"00",x"D6",x"08",x"20",x"0F",x"DB", -- 0x01E8
    x"40",x"E6",x"01",x"4F",x"06",x"00",x"79",x"3D", -- 0x01F0
    x"B0",x"20",x"03",x"CD",x"B9",x"01",x"CD",x"02", -- 0x01F8
    x"09",x"11",x"01",x"0F",x"D5",x"3E",x"01",x"F5", -- 0x0200
    x"33",x"CD",x"C7",x"09",x"33",x"21",x"56",x"01", -- 0x0208
    x"E3",x"CD",x"13",x"0B",x"F1",x"CD",x"77",x"0C", -- 0x0210
    x"CB",x"45",x"28",x"04",x"1E",x"01",x"18",x"09", -- 0x0218
    x"CB",x"55",x"28",x"03",x"1E",x"02",x"CA",x"1E", -- 0x0220
    x"00",x"01",x"32",x"01",x"16",x"00",x"6B",x"62", -- 0x0228
    x"29",x"19",x"29",x"29",x"09",x"4D",x"44",x"21", -- 0x0230
    x"0C",x"00",x"39",x"FD",x"21",x"30",x"00",x"FD", -- 0x0238
    x"39",x"FD",x"75",x"00",x"FD",x"74",x"01",x"FD", -- 0x0240
    x"5E",x"00",x"FD",x"56",x"01",x"C5",x"21",x"60", -- 0x0248
    x"04",x"AF",x"BE",x"ED",x"A0",x"20",x"FB",x"C1", -- 0x0250
    x"FD",x"5E",x"00",x"FD",x"56",x"01",x"C5",x"C5", -- 0x0258
    x"D5",x"CD",x"AA",x"1B",x"F1",x"F1",x"C1",x"21", -- 0x0260
    x"30",x"00",x"39",x"5E",x"23",x"56",x"C5",x"D5", -- 0x0268
    x"3E",x"09",x"F5",x"33",x"CD",x"03",x"01",x"F1", -- 0x0270
    x"33",x"CD",x"26",x"0B",x"7D",x"C1",x"B7",x"20", -- 0x0278
    x"0A",x"C5",x"21",x"69",x"04",x"E5",x"CD",x"77", -- 0x0280
    x"01",x"F1",x"C1",x"C5",x"CD",x"6B",x"0E",x"7D", -- 0x0288
    x"C1",x"B7",x"20",x"0A",x"C5",x"21",x"8A",x"04", -- 0x0290
    x"E5",x"CD",x"77",x"01",x"F1",x"C1",x"21",x"00", -- 0x0298
    x"00",x"39",x"FD",x"21",x"2E",x"00",x"FD",x"39", -- 0x02A0
    x"FD",x"75",x"00",x"FD",x"74",x"01",x"FD",x"5E", -- 0x02A8
    x"00",x"FD",x"56",x"01",x"C5",x"D5",x"CD",x"BE", -- 0x02B0
    x"16",x"F1",x"F1",x"7D",x"B7",x"20",x"08",x"21", -- 0x02B8
    x"A1",x"04",x"E5",x"CD",x"77",x"01",x"F1",x"21", -- 0x02C0
    x"2C",x"00",x"39",x"FD",x"21",x"2E",x"00",x"FD", -- 0x02C8
    x"39",x"FD",x"7E",x"00",x"C6",x"04",x"77",x"FD", -- 0x02D0
    x"7E",x"01",x"CE",x"00",x"23",x"77",x"21",x"2C", -- 0x02D8
    x"00",x"39",x"7E",x"23",x"66",x"6F",x"4E",x"23", -- 0x02E0
    x"46",x"23",x"5E",x"23",x"56",x"79",x"B7",x"20", -- 0x02E8
    x"07",x"78",x"D6",x"20",x"B3",x"B2",x"28",x"08", -- 0x02F0
    x"21",x"B6",x"04",x"E5",x"CD",x"77",x"01",x"F1", -- 0x02F8
    x"21",x"2E",x"00",x"39",x"5E",x"23",x"56",x"01", -- 0x0300
    x"00",x"00",x"FD",x"21",x"34",x"00",x"FD",x"39", -- 0x0308
    x"FD",x"36",x"00",x"00",x"6B",x"62",x"C5",x"D5", -- 0x0310
    x"C5",x"E5",x"CD",x"48",x"1A",x"F1",x"F1",x"7D", -- 0x0318
    x"D1",x"C1",x"B7",x"20",x"0C",x"C5",x"D5",x"21", -- 0x0320
    x"D2",x"04",x"E5",x"CD",x"77",x"01",x"F1",x"D1", -- 0x0328
    x"C1",x"21",x"00",x"02",x"09",x"4D",x"44",x"FD", -- 0x0330
    x"21",x"34",x"00",x"FD",x"39",x"FD",x"34",x"00", -- 0x0338
    x"FD",x"7E",x"00",x"D6",x"10",x"38",x"CD",x"21", -- 0x0340
    x"00",x"80",x"7E",x"FD",x"21",x"32",x"00",x"FD", -- 0x0348
    x"39",x"FD",x"77",x"00",x"23",x"7E",x"FD",x"77", -- 0x0350
    x"01",x"FD",x"7E",x"00",x"D6",x"AA",x"20",x"07", -- 0x0358
    x"FD",x"7E",x"01",x"D6",x"55",x"28",x"0E",x"FD", -- 0x0360
    x"7E",x"00",x"D6",x"55",x"20",x"0D",x"FD",x"7E", -- 0x0368
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
    x"51",x"CD",x"F9",x"0B",x"30",x"03",x"2E",x"00", -- 0x0BC8
    x"C9",x"CD",x"5B",x"0C",x"38",x"F8",x"01",x"41", -- 0x0BD0
    x"00",x"ED",x"B2",x"ED",x"B2",x"00",x"DB",x"41", -- 0x0BD8
    x"00",x"DB",x"41",x"2E",x"01",x"C9",x"41",x"4A", -- 0x0BE0
    x"53",x"1E",x"00",x"CB",x"22",x"CB",x"11",x"CB", -- 0x0BE8
    x"10",x"C9",x"3E",x"41",x"01",x"00",x"00",x"50", -- 0x0BF0
    x"59",x"CD",x"34",x"0C",x"B7",x"C8",x"37",x"C9", -- 0x0BF8
    x"3E",x"77",x"CD",x"F4",x"0B",x"3E",x"69",x"01", -- 0x0C00
    x"00",x"40",x"51",x"59",x"18",x"EB",x"01",x"00", -- 0x0C08
    x"00",x"CD",x"34",x"0C",x"47",x"E6",x"FE",x"78", -- 0x0C10
    x"20",x"E4",x"C9",x"CD",x"0E",x"0C",x"D8",x"F5", -- 0x0C18
    x"CD",x"69",x"0C",x"67",x"CD",x"69",x"0C",x"6F", -- 0x0C20
    x"CD",x"69",x"0C",x"57",x"CD",x"69",x"0C",x"5F", -- 0x0C28
    x"44",x"4D",x"F1",x"C9",x"D3",x"41",x"F5",x"78", -- 0x0C30
    x"00",x"D3",x"41",x"79",x"00",x"D3",x"41",x"7A", -- 0x0C38
    x"00",x"D3",x"41",x"7B",x"00",x"D3",x"41",x"F1", -- 0x0C40
    x"FE",x"40",x"06",x"95",x"28",x"08",x"FE",x"48", -- 0x0C48
    x"06",x"87",x"28",x"02",x"06",x"FF",x"78",x"D3", -- 0x0C50
    x"41",x"18",x"0E",x"06",x"0A",x"C5",x"CD",x"69", -- 0x0C58
    x"0C",x"C1",x"FE",x"FE",x"C8",x"10",x"F6",x"37", -- 0x0C60
    x"C9",x"01",x"64",x"00",x"DB",x"41",x"FE",x"FF", -- 0x0C68
    x"C0",x"10",x"F9",x"0D",x"20",x"F6",x"C9",x"D3", -- 0x0C70
    x"C0",x"DB",x"FC",x"2F",x"E6",x"4F",x"6F",x"C9", -- 0x0C78
    x"F5",x"F5",x"F5",x"F5",x"FD",x"21",x"06",x"60", -- 0x0C80
    x"FD",x"7E",x"01",x"FD",x"B6",x"00",x"28",x"6A", -- 0x0C88
    x"21",x"0A",x"00",x"39",x"7E",x"FD",x"21",x"04", -- 0x0C90
    x"00",x"FD",x"39",x"FD",x"77",x"00",x"21",x"0B", -- 0x0C98
    x"00",x"39",x"7E",x"FD",x"21",x"04",x"00",x"FD", -- 0x0CA0
    x"39",x"FD",x"77",x"01",x"21",x"0C",x"00",x"39", -- 0x0CA8
    x"7E",x"FD",x"21",x"04",x"00",x"FD",x"39",x"FD", -- 0x0CB0
    x"77",x"02",x"21",x"0D",x"00",x"39",x"7E",x"FD", -- 0x0CB8
    x"21",x"04",x"00",x"FD",x"39",x"FD",x"77",x"03", -- 0x0CC0
    x"06",x"07",x"FD",x"CB",x"03",x"3E",x"FD",x"CB", -- 0x0CC8
    x"02",x"1E",x"FD",x"CB",x"01",x"1E",x"FD",x"CB", -- 0x0CD0
    x"00",x"1E",x"10",x"EE",x"21",x"0A",x"00",x"39", -- 0x0CD8
    x"7E",x"E6",x"7F",x"FD",x"21",x"00",x"00",x"FD", -- 0x0CE0
    x"39",x"FD",x"77",x"00",x"FD",x"36",x"01",x"00", -- 0x0CE8
    x"FD",x"36",x"02",x"00",x"FD",x"36",x"03",x"00", -- 0x0CF0
    x"18",x"48",x"21",x"0B",x"00",x"39",x"7E",x"FD", -- 0x0CF8
    x"21",x"04",x"00",x"FD",x"39",x"FD",x"77",x"00", -- 0x0D00
    x"21",x"0C",x"00",x"39",x"7E",x"FD",x"21",x"04", -- 0x0D08
    x"00",x"FD",x"39",x"FD",x"77",x"01",x"21",x"0D", -- 0x0D10
    x"00",x"39",x"7E",x"FD",x"21",x"04",x"00",x"FD", -- 0x0D18
    x"39",x"FD",x"77",x"02",x"FD",x"36",x"03",x"00", -- 0x0D20
    x"21",x"0A",x"00",x"39",x"7E",x"FD",x"21",x"00", -- 0x0D28
    x"00",x"FD",x"39",x"FD",x"77",x"00",x"FD",x"36", -- 0x0D30
    x"01",x"00",x"FD",x"36",x"02",x"00",x"FD",x"36", -- 0x0D38
    x"03",x"00",x"3A",x"30",x"62",x"FD",x"21",x"04", -- 0x0D40
    x"00",x"FD",x"39",x"FD",x"96",x"00",x"20",x"2A", -- 0x0D48
    x"3A",x"31",x"62",x"FD",x"21",x"04",x"00",x"FD", -- 0x0D50
    x"39",x"FD",x"96",x"01",x"20",x"1C",x"3A",x"32", -- 0x0D58
    x"62",x"FD",x"21",x"04",x"00",x"FD",x"39",x"FD", -- 0x0D60
    x"96",x"02",x"20",x"0E",x"3A",x"33",x"62",x"FD", -- 0x0D68
    x"21",x"04",x"00",x"FD",x"39",x"FD",x"96",x"03", -- 0x0D70
    x"28",x"42",x"21",x"04",x"00",x"39",x"FD",x"21", -- 0x0D78
    x"08",x"60",x"FD",x"7E",x"00",x"86",x"4F",x"FD", -- 0x0D80
    x"7E",x"01",x"23",x"8E",x"47",x"FD",x"7E",x"02", -- 0x0D88
    x"23",x"8E",x"5F",x"FD",x"7E",x"03",x"23",x"8E", -- 0x0D90
    x"57",x"21",x"2E",x"60",x"E5",x"D5",x"C5",x"CD", -- 0x0D98
    x"A4",x"0B",x"F1",x"F1",x"F1",x"7D",x"B7",x"20", -- 0x0DA0
    x"07",x"21",x"00",x"00",x"5D",x"54",x"18",x"3D", -- 0x0DA8
    x"11",x"30",x"62",x"21",x"04",x"00",x"39",x"01", -- 0x0DB0
    x"04",x"00",x"ED",x"B0",x"C1",x"C5",x"FD",x"21", -- 0x0DB8
    x"06",x"60",x"FD",x"7E",x"01",x"FD",x"B6",x"00", -- 0x0DC0
    x"28",x"14",x"11",x"2E",x"60",x"69",x"60",x"29", -- 0x0DC8
    x"29",x"19",x"4E",x"23",x"46",x"23",x"5E",x"23", -- 0x0DD0
    x"7E",x"E6",x"0F",x"57",x"18",x"0D",x"11",x"2E", -- 0x0DD8
    x"60",x"69",x"60",x"29",x"19",x"4E",x"23",x"46", -- 0x0DE0
    x"11",x"00",x"00",x"69",x"60",x"F1",x"F1",x"F1", -- 0x0DE8
    x"F1",x"C9",x"F5",x"F5",x"21",x"06",x"00",x"39", -- 0x0DF0
    x"4E",x"23",x"46",x"21",x"08",x"00",x"39",x"7E", -- 0x0DF8
    x"FD",x"21",x"00",x"00",x"FD",x"39",x"FD",x"77", -- 0x0E00
    x"00",x"21",x"09",x"00",x"39",x"7E",x"FD",x"21", -- 0x0E08
    x"00",x"00",x"FD",x"39",x"FD",x"77",x"01",x"21", -- 0x0E10
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
    x"77",x"FD",x"7E",x"01",x"CE",x"FF",x"23",x"77", -- 0x1030
    x"FD",x"7E",x"02",x"CE",x"FF",x"23",x"77",x"FD", -- 0x1038
    x"7E",x"03",x"CE",x"FF",x"23",x"77",x"3A",x"3C", -- 0x1040
    x"60",x"FD",x"21",x"08",x"00",x"FD",x"39",x"FD", -- 0x1048
    x"77",x"00",x"FD",x"7E",x"00",x"FD",x"21",x"00", -- 0x1050
    x"00",x"FD",x"39",x"FD",x"77",x"00",x"FD",x"36", -- 0x1058
    x"01",x"00",x"FD",x"36",x"02",x"00",x"FD",x"36", -- 0x1060
    x"03",x"00",x"21",x"04",x"00",x"39",x"D5",x"FD", -- 0x1068
    x"E5",x"D1",x"1A",x"86",x"12",x"13",x"1A",x"23", -- 0x1070
    x"8E",x"12",x"13",x"1A",x"23",x"8E",x"12",x"13", -- 0x1078
    x"1A",x"23",x"8E",x"12",x"D1",x"3A",x"3D",x"60", -- 0x1080
    x"FD",x"21",x"04",x"00",x"FD",x"39",x"FD",x"77", -- 0x1088
    x"00",x"FD",x"7E",x"00",x"FD",x"77",x"00",x"FD", -- 0x1090
    x"36",x"01",x"00",x"FD",x"7E",x"00",x"FD",x"77", -- 0x1098
    x"01",x"FD",x"36",x"00",x"00",x"FD",x"7E",x"00", -- 0x10A0
    x"FD",x"77",x"00",x"FD",x"7E",x"01",x"FD",x"77", -- 0x10A8
    x"01",x"17",x"9F",x"FD",x"77",x"02",x"FD",x"77", -- 0x10B0
    x"03",x"21",x"04",x"00",x"39",x"D5",x"11",x"08", -- 0x10B8
    x"60",x"FD",x"21",x"02",x"00",x"FD",x"39",x"FD", -- 0x10C0
    x"7E",x"00",x"86",x"12",x"FD",x"7E",x"01",x"23", -- 0x10C8
    x"8E",x"13",x"12",x"FD",x"7E",x"02",x"23",x"8E", -- 0x10D0
    x"13",x"12",x"FD",x"7E",x"03",x"23",x"8E",x"13", -- 0x10D8
    x"12",x"D1",x"3A",x"3E",x"60",x"FD",x"21",x"1C", -- 0x10E0
    x"60",x"FD",x"77",x"00",x"FD",x"36",x"01",x"00", -- 0x10E8
    x"FD",x"21",x"06",x"60",x"FD",x"7E",x"01",x"FD", -- 0x10F0
    x"B6",x"00",x"CA",x"96",x"14",x"21",x"08",x"00", -- 0x10F8
    x"E5",x"21",x"B5",x"16",x"E5",x"21",x"80",x"60", -- 0x1100
    x"E5",x"CD",x"F2",x"0D",x"F1",x"F1",x"F1",x"7C", -- 0x1108
    x"B5",x"28",x"05",x"2E",x"00",x"C3",x"A3",x"16", -- 0x1110
    x"3A",x"1E",x"60",x"32",x"26",x"60",x"3A",x"1F", -- 0x1118
    x"60",x"32",x"27",x"60",x"3A",x"20",x"60",x"32", -- 0x1120
    x"28",x"60",x"3A",x"21",x"60",x"FD",x"21",x"26", -- 0x1128
    x"60",x"FD",x"77",x"03",x"06",x"04",x"FD",x"CB", -- 0x1130
    x"00",x"26",x"FD",x"CB",x"01",x"16",x"FD",x"CB", -- 0x1138
    x"02",x"16",x"FD",x"CB",x"03",x"16",x"10",x"EE", -- 0x1140
    x"11",x"18",x"60",x"21",x"1E",x"60",x"01",x"04", -- 0x1148
    x"00",x"ED",x"B0",x"3A",x"52",x"60",x"33",x"F5", -- 0x1150
    x"33",x"3A",x"53",x"60",x"FD",x"21",x"04",x"00", -- 0x1158
    x"FD",x"39",x"FD",x"77",x"00",x"FD",x"7E",x"00", -- 0x1160
    x"FD",x"77",x"00",x"FD",x"36",x"01",x"00",x"FD", -- 0x1168
    x"36",x"02",x"00",x"FD",x"36",x"03",x"00",x"06", -- 0x1170
    x"08",x"FD",x"CB",x"00",x"26",x"FD",x"CB",x"01", -- 0x1178
    x"16",x"FD",x"CB",x"02",x"16",x"FD",x"CB",x"03", -- 0x1180
    x"16",x"10",x"EE",x"FD",x"21",x"00",x"00",x"FD", -- 0x1188
    x"39",x"FD",x"7E",x"00",x"FD",x"77",x"00",x"FD", -- 0x1190
    x"36",x"01",x"00",x"FD",x"36",x"02",x"00",x"FD", -- 0x1198
    x"36",x"03",x"00",x"21",x"00",x"00",x"39",x"FD", -- 0x11A0
    x"21",x"04",x"00",x"FD",x"39",x"FD",x"7E",x"00", -- 0x11A8
    x"86",x"77",x"FD",x"7E",x"01",x"23",x"8E",x"77", -- 0x11B0
    x"FD",x"7E",x"02",x"23",x"8E",x"77",x"FD",x"7E", -- 0x11B8
    x"03",x"23",x"8E",x"77",x"3A",x"54",x"60",x"FD", -- 0x11C0
    x"77",x"00",x"FD",x"7E",x"00",x"FD",x"77",x"00", -- 0x11C8
    x"FD",x"36",x"01",x"00",x"FD",x"36",x"02",x"00", -- 0x11D0
    x"FD",x"36",x"03",x"00",x"06",x"10",x"FD",x"CB", -- 0x11D8
    x"00",x"26",x"FD",x"CB",x"01",x"16",x"FD",x"CB", -- 0x11E0
    x"02",x"16",x"FD",x"CB",x"03",x"16",x"10",x"EE", -- 0x11E8
    x"21",x"04",x"00",x"39",x"D5",x"FD",x"21",x"02", -- 0x11F0
    x"00",x"FD",x"39",x"FD",x"E5",x"D1",x"1A",x"86", -- 0x11F8
    x"12",x"13",x"1A",x"23",x"8E",x"12",x"13",x"1A", -- 0x1200
    x"23",x"8E",x"12",x"13",x"1A",x"23",x"8E",x"12", -- 0x1208
    x"D1",x"3A",x"55",x"60",x"FD",x"21",x"04",x"00", -- 0x1210
    x"FD",x"39",x"FD",x"77",x"00",x"FD",x"7E",x"00", -- 0x1218
    x"FD",x"77",x"00",x"FD",x"36",x"01",x"00",x"FD", -- 0x1220
    x"36",x"02",x"00",x"FD",x"36",x"03",x"00",x"06", -- 0x1228
    x"18",x"FD",x"CB",x"00",x"26",x"FD",x"CB",x"01", -- 0x1230
    x"16",x"FD",x"CB",x"02",x"16",x"FD",x"CB",x"03", -- 0x1238
    x"16",x"10",x"EE",x"21",x"04",x"00",x"39",x"D5", -- 0x1240
    x"11",x"2A",x"60",x"FD",x"21",x"02",x"00",x"FD", -- 0x1248
    x"39",x"FD",x"7E",x"00",x"86",x"12",x"FD",x"7E", -- 0x1250
    x"01",x"23",x"8E",x"13",x"12",x"FD",x"7E",x"02", -- 0x1258
    x"23",x"8E",x"13",x"12",x"FD",x"7E",x"03",x"23", -- 0x1260
    x"8E",x"13",x"12",x"D1",x"3A",x"1C",x"60",x"FD", -- 0x1268
    x"21",x"00",x"00",x"FD",x"39",x"FD",x"77",x"00", -- 0x1270
    x"3A",x"1D",x"60",x"FD",x"21",x"00",x"00",x"FD", -- 0x1278
    x"39",x"FD",x"77",x"01",x"FD",x"36",x"02",x"00", -- 0x1280
    x"FD",x"36",x"03",x"00",x"2A",x"2C",x"60",x"E5", -- 0x1288
    x"2A",x"2A",x"60",x"E5",x"FD",x"6E",x"02",x"FD", -- 0x1290
    x"66",x"03",x"E5",x"FD",x"6E",x"00",x"FD",x"66", -- 0x1298
    x"01",x"E5",x"CD",x"FE",x"1B",x"F1",x"F1",x"F1", -- 0x12A0
    x"F1",x"FD",x"21",x"00",x"00",x"FD",x"39",x"FD", -- 0x12A8
    x"72",x"03",x"FD",x"73",x"02",x"FD",x"74",x"01", -- 0x12B0
    x"FD",x"75",x"00",x"21",x"00",x"00",x"39",x"D5", -- 0x12B8
    x"11",x"0C",x"60",x"FD",x"21",x"08",x"60",x"FD", -- 0x12C0
    x"7E",x"00",x"86",x"12",x"FD",x"7E",x"01",x"23", -- 0x12C8
    x"8E",x"13",x"12",x"FD",x"7E",x"02",x"23",x"8E", -- 0x12D0
    x"13",x"12",x"FD",x"7E",x"03",x"23",x"8E",x"13", -- 0x12D8
    x"12",x"D1",x"3A",x"5A",x"60",x"33",x"F5",x"33", -- 0x12E0
    x"3A",x"5B",x"60",x"FD",x"21",x"04",x"00",x"FD", -- 0x12E8
    x"39",x"FD",x"77",x"00",x"FD",x"7E",x"00",x"FD", -- 0x12F0
    x"77",x"00",x"FD",x"36",x"01",x"00",x"FD",x"36", -- 0x12F8
    x"02",x"00",x"FD",x"36",x"03",x"00",x"06",x"08", -- 0x1300
    x"FD",x"CB",x"00",x"26",x"FD",x"CB",x"01",x"16", -- 0x1308
    x"FD",x"CB",x"02",x"16",x"FD",x"CB",x"03",x"16", -- 0x1310
    x"10",x"EE",x"FD",x"21",x"00",x"00",x"FD",x"39", -- 0x1318
    x"FD",x"7E",x"00",x"FD",x"77",x"00",x"FD",x"36", -- 0x1320
    x"01",x"00",x"FD",x"36",x"02",x"00",x"FD",x"36", -- 0x1328
    x"03",x"00",x"21",x"00",x"00",x"39",x"FD",x"21", -- 0x1330
    x"04",x"00",x"FD",x"39",x"FD",x"7E",x"00",x"86", -- 0x1338
    x"77",x"FD",x"7E",x"01",x"23",x"8E",x"77",x"FD", -- 0x1340
    x"7E",x"02",x"23",x"8E",x"77",x"FD",x"7E",x"03", -- 0x1348
    x"23",x"8E",x"77",x"3A",x"5C",x"60",x"FD",x"77", -- 0x1350
    x"00",x"FD",x"7E",x"00",x"FD",x"77",x"00",x"FD", -- 0x1358
    x"36",x"01",x"00",x"FD",x"36",x"02",x"00",x"FD", -- 0x1360
    x"36",x"03",x"00",x"06",x"10",x"FD",x"CB",x"00", -- 0x1368
    x"26",x"FD",x"CB",x"01",x"16",x"FD",x"CB",x"02", -- 0x1370
    x"16",x"FD",x"CB",x"03",x"16",x"10",x"EE",x"21", -- 0x1378
    x"04",x"00",x"39",x"D5",x"FD",x"21",x"02",x"00", -- 0x1380
    x"FD",x"39",x"FD",x"E5",x"D1",x"1A",x"86",x"12", -- 0x1388
    x"13",x"1A",x"23",x"8E",x"12",x"13",x"1A",x"23", -- 0x1390
    x"8E",x"12",x"13",x"1A",x"23",x"8E",x"12",x"D1", -- 0x1398
    x"3A",x"5D",x"60",x"FD",x"21",x"04",x"00",x"FD", -- 0x13A0
    x"39",x"FD",x"77",x"00",x"FD",x"7E",x"00",x"FD", -- 0x13A8
    x"77",x"00",x"FD",x"36",x"01",x"00",x"FD",x"7E", -- 0x13B0
    x"00",x"E6",x"0F",x"FD",x"77",x"00",x"FD",x"36", -- 0x13B8
    x"01",x"00",x"FD",x"7E",x"00",x"FD",x"77",x"00", -- 0x13C0
    x"FD",x"7E",x"01",x"FD",x"77",x"01",x"17",x"9F", -- 0x13C8
    x"FD",x"77",x"02",x"FD",x"77",x"03",x"06",x"18", -- 0x13D0
    x"FD",x"CB",x"00",x"26",x"FD",x"CB",x"01",x"16", -- 0x13D8
    x"FD",x"CB",x"02",x"16",x"FD",x"CB",x"03",x"16", -- 0x13E0
    x"10",x"EE",x"21",x"04",x"00",x"39",x"D5",x"11", -- 0x13E8
    x"10",x"60",x"FD",x"21",x"02",x"00",x"FD",x"39", -- 0x13F0
    x"FD",x"7E",x"00",x"86",x"12",x"FD",x"7E",x"01", -- 0x13F8
    x"23",x"8E",x"13",x"12",x"FD",x"7E",x"02",x"23", -- 0x1400
    x"8E",x"13",x"12",x"FD",x"7E",x"03",x"23",x"8E", -- 0x1408
    x"13",x"12",x"D1",x"21",x"00",x"00",x"39",x"FD", -- 0x1410
    x"21",x"10",x"60",x"FD",x"7E",x"00",x"C6",x"FE", -- 0x1418
    x"77",x"FD",x"7E",x"01",x"CE",x"FF",x"23",x"77", -- 0x1420
    x"FD",x"7E",x"02",x"CE",x"FF",x"23",x"77",x"FD", -- 0x1428
    x"7E",x"03",x"CE",x"FF",x"23",x"77",x"2A",x"20", -- 0x1430
    x"60",x"E5",x"2A",x"1E",x"60",x"E5",x"FD",x"21", -- 0x1438
    x"04",x"00",x"FD",x"39",x"FD",x"6E",x"02",x"FD", -- 0x1440
    x"66",x"03",x"E5",x"FD",x"6E",x"00",x"FD",x"66", -- 0x1448
    x"01",x"E5",x"CD",x"FE",x"1B",x"F1",x"F1",x"F1", -- 0x1450
    x"F1",x"FD",x"21",x"00",x"00",x"FD",x"39",x"FD", -- 0x1458
    x"72",x"03",x"FD",x"73",x"02",x"FD",x"74",x"01", -- 0x1460
    x"FD",x"75",x"00",x"21",x"0C",x"60",x"D5",x"11", -- 0x1468
    x"14",x"60",x"FD",x"21",x"02",x"00",x"FD",x"39", -- 0x1470
    x"FD",x"7E",x"00",x"86",x"12",x"FD",x"7E",x"01", -- 0x1478
    x"23",x"8E",x"13",x"12",x"FD",x"7E",x"02",x"23", -- 0x1480
    x"8E",x"13",x"12",x"FD",x"7E",x"03",x"23",x"8E", -- 0x1488
    x"13",x"12",x"D1",x"C3",x"A1",x"16",x"3A",x"3F", -- 0x1490
    x"60",x"FD",x"21",x"00",x"00",x"FD",x"39",x"FD", -- 0x1498
    x"77",x"00",x"FD",x"36",x"01",x"00",x"3A",x"40", -- 0x14A0
    x"60",x"FD",x"21",x"04",x"00",x"FD",x"39",x"FD", -- 0x14A8
    x"77",x"00",x"FD",x"7E",x"00",x"FD",x"77",x"00", -- 0x14B0
    x"FD",x"36",x"01",x"00",x"FD",x"7E",x"00",x"FD", -- 0x14B8
    x"77",x"01",x"FD",x"36",x"00",x"00",x"21",x"00", -- 0x14C0
    x"00",x"39",x"D5",x"FD",x"21",x"02",x"00",x"FD", -- 0x14C8
    x"39",x"FD",x"E5",x"D1",x"FD",x"21",x"06",x"00", -- 0x14D0
    x"FD",x"39",x"FD",x"7E",x"00",x"86",x"12",x"FD", -- 0x14D8
    x"7E",x"01",x"23",x"8E",x"13",x"12",x"D1",x"21", -- 0x14E0
    x"00",x"00",x"39",x"7E",x"32",x"26",x"60",x"21", -- 0x14E8
    x"01",x"00",x"39",x"7E",x"FD",x"21",x"26",x"60", -- 0x14F0
    x"FD",x"77",x"01",x"17",x"9F",x"FD",x"77",x"02", -- 0x14F8
    x"FD",x"77",x"03",x"FD",x"7E",x"00",x"FD",x"21", -- 0x1500
    x"00",x"00",x"FD",x"39",x"FD",x"77",x"00",x"3A", -- 0x1508
    x"27",x"60",x"FD",x"21",x"00",x"00",x"FD",x"39", -- 0x1510
    x"FD",x"77",x"01",x"3A",x"28",x"60",x"FD",x"21", -- 0x1518
    x"00",x"00",x"FD",x"39",x"FD",x"77",x"02",x"3A", -- 0x1520
    x"29",x"60",x"FD",x"21",x"00",x"00",x"FD",x"39", -- 0x1528
    x"FD",x"77",x"03",x"06",x"05",x"FD",x"CB",x"00", -- 0x1530
    x"26",x"FD",x"CB",x"01",x"16",x"FD",x"CB",x"02", -- 0x1538
    x"16",x"FD",x"CB",x"03",x"16",x"10",x"EE",x"21", -- 0x1540
    x"00",x"00",x"39",x"7E",x"C6",x"FF",x"77",x"23", -- 0x1548
    x"7E",x"CE",x"01",x"77",x"23",x"7E",x"CE",x"00", -- 0x1550
    x"77",x"30",x"02",x"23",x"34",x"FD",x"7E",x"01", -- 0x1558
    x"32",x"18",x"60",x"21",x"02",x"00",x"39",x"7E", -- 0x1560
    x"32",x"19",x"60",x"21",x"03",x"00",x"39",x"7E", -- 0x1568
    x"FD",x"21",x"18",x"60",x"FD",x"77",x"02",x"FD", -- 0x1570
    x"36",x"03",x"00",x"FD",x"CB",x"02",x"3E",x"FD", -- 0x1578
    x"CB",x"01",x"1E",x"FD",x"CB",x"00",x"1E",x"3A", -- 0x1580
    x"44",x"60",x"FD",x"21",x"00",x"00",x"FD",x"39", -- 0x1588
    x"FD",x"77",x"00",x"FD",x"36",x"01",x"00",x"3A", -- 0x1590
    x"45",x"60",x"FD",x"21",x"04",x"00",x"FD",x"39", -- 0x1598
    x"FD",x"77",x"00",x"FD",x"7E",x"00",x"FD",x"77", -- 0x15A0
    x"00",x"FD",x"36",x"01",x"00",x"FD",x"7E",x"00", -- 0x15A8
    x"FD",x"77",x"01",x"FD",x"36",x"00",x"00",x"21", -- 0x15B0
    x"00",x"00",x"39",x"D5",x"FD",x"21",x"02",x"00", -- 0x15B8
    x"FD",x"39",x"FD",x"E5",x"D1",x"FD",x"21",x"06", -- 0x15C0
    x"00",x"FD",x"39",x"FD",x"7E",x"00",x"86",x"12", -- 0x15C8
    x"FD",x"7E",x"01",x"23",x"8E",x"13",x"12",x"D1", -- 0x15D0
    x"21",x"00",x"00",x"39",x"7E",x"32",x"2A",x"60", -- 0x15D8
    x"21",x"01",x"00",x"39",x"7E",x"FD",x"21",x"2A", -- 0x15E0
    x"60",x"FD",x"77",x"01",x"17",x"9F",x"FD",x"77", -- 0x15E8
    x"02",x"FD",x"77",x"03",x"3A",x"1C",x"60",x"FD", -- 0x15F0
    x"21",x"00",x"00",x"FD",x"39",x"FD",x"77",x"00", -- 0x15F8
    x"3A",x"1D",x"60",x"FD",x"21",x"00",x"00",x"FD", -- 0x1600
    x"39",x"FD",x"77",x"01",x"FD",x"36",x"02",x"00", -- 0x1608
    x"FD",x"36",x"03",x"00",x"2A",x"2C",x"60",x"E5", -- 0x1610
    x"2A",x"2A",x"60",x"E5",x"FD",x"6E",x"02",x"FD", -- 0x1618
    x"66",x"03",x"E5",x"FD",x"6E",x"00",x"FD",x"66", -- 0x1620
    x"01",x"E5",x"CD",x"FE",x"1B",x"F1",x"F1",x"F1", -- 0x1628
    x"F1",x"FD",x"21",x"00",x"00",x"FD",x"39",x"FD", -- 0x1630
    x"72",x"03",x"FD",x"73",x"02",x"FD",x"74",x"01", -- 0x1638
    x"FD",x"75",x"00",x"21",x"00",x"00",x"39",x"D5", -- 0x1640
    x"11",x"14",x"60",x"FD",x"21",x"08",x"60",x"FD", -- 0x1648
    x"7E",x"00",x"86",x"12",x"FD",x"7E",x"01",x"23", -- 0x1650
    x"8E",x"13",x"12",x"FD",x"7E",x"02",x"23",x"8E", -- 0x1658
    x"13",x"12",x"FD",x"7E",x"03",x"23",x"8E",x"13", -- 0x1660
    x"12",x"D1",x"AF",x"FD",x"21",x"10",x"60",x"FD", -- 0x1668
    x"77",x"00",x"FD",x"77",x"01",x"FD",x"77",x"02", -- 0x1670
    x"FD",x"77",x"03",x"21",x"18",x"60",x"D5",x"11", -- 0x1678
    x"0C",x"60",x"FD",x"21",x"14",x"60",x"FD",x"7E", -- 0x1680
    x"00",x"86",x"12",x"FD",x"7E",x"01",x"23",x"8E", -- 0x1688
    x"13",x"12",x"FD",x"7E",x"02",x"23",x"8E",x"13", -- 0x1690
    x"12",x"FD",x"7E",x"03",x"23",x"8E",x"13",x"12", -- 0x1698
    x"D1",x"2E",x"01",x"FD",x"21",x"0B",x"00",x"FD", -- 0x16A0
    x"39",x"FD",x"F9",x"C9",x"46",x"41",x"54",x"31", -- 0x16A8
    x"36",x"20",x"20",x"20",x"00",x"46",x"41",x"54", -- 0x16B0
    x"33",x"32",x"20",x"20",x"20",x"00",x"21",x"E0", -- 0x16B8
    x"FF",x"39",x"F9",x"21",x"1E",x"00",x"39",x"AF", -- 0x16C0
    x"77",x"23",x"77",x"FD",x"21",x"30",x"62",x"FD", -- 0x16C8
    x"36",x"00",x"FF",x"FD",x"36",x"01",x"FF",x"FD", -- 0x16D0
    x"36",x"02",x"FF",x"FD",x"36",x"03",x"FF",x"21", -- 0x16D8
    x"1A",x"00",x"39",x"EB",x"21",x"10",x"60",x"01", -- 0x16E0
    x"04",x"00",x"ED",x"B0",x"21",x"0E",x"00",x"39", -- 0x16E8
    x"EB",x"21",x"14",x"60",x"01",x"04",x"00",x"ED", -- 0x16F0
    x"B0",x"FD",x"21",x"06",x"60",x"FD",x"7E",x"01", -- 0x16F8
    x"FD",x"B6",x"00",x"28",x"46",x"3A",x"1E",x"60", -- 0x1700
    x"FD",x"21",x"12",x"00",x"FD",x"39",x"FD",x"77", -- 0x1708
    x"00",x"3A",x"1F",x"60",x"FD",x"21",x"12",x"00", -- 0x1710
    x"FD",x"39",x"FD",x"77",x"01",x"3A",x"20",x"60", -- 0x1718
    x"FD",x"21",x"12",x"00",x"FD",x"39",x"FD",x"77", -- 0x1720
    x"02",x"3A",x"21",x"60",x"FD",x"21",x"12",x"00", -- 0x1728
    x"FD",x"39",x"FD",x"77",x"03",x"06",x"04",x"FD", -- 0x1730
    x"CB",x"00",x"26",x"FD",x"CB",x"01",x"16",x"FD", -- 0x1738
    x"CB",x"02",x"16",x"FD",x"CB",x"03",x"16",x"10", -- 0x1740
    x"EE",x"18",x"44",x"3A",x"18",x"60",x"FD",x"21", -- 0x1748
    x"12",x"00",x"FD",x"39",x"FD",x"77",x"00",x"3A", -- 0x1750
    x"19",x"60",x"FD",x"21",x"12",x"00",x"FD",x"39", -- 0x1758
    x"FD",x"77",x"01",x"3A",x"1A",x"60",x"FD",x"21", -- 0x1760
    x"12",x"00",x"FD",x"39",x"FD",x"77",x"02",x"3A", -- 0x1768
    x"1B",x"60",x"FD",x"21",x"12",x"00",x"FD",x"39", -- 0x1770
    x"FD",x"77",x"03",x"06",x"04",x"FD",x"CB",x"00", -- 0x1778
    x"26",x"FD",x"CB",x"01",x"16",x"FD",x"CB",x"02", -- 0x1780
    x"16",x"FD",x"CB",x"03",x"16",x"10",x"EE",x"21", -- 0x1788
    x"0A",x"00",x"39",x"EB",x"21",x"0E",x"00",x"39", -- 0x1790
    x"01",x"04",x"00",x"ED",x"B0",x"AF",x"FD",x"21", -- 0x1798
    x"16",x"00",x"FD",x"39",x"FD",x"77",x"00",x"FD", -- 0x17A0
    x"77",x"01",x"FD",x"77",x"02",x"FD",x"77",x"03", -- 0x17A8
    x"21",x"12",x"00",x"39",x"FD",x"21",x"16",x"00", -- 0x17B0
    x"FD",x"39",x"FD",x"7E",x"00",x"96",x"FD",x"7E", -- 0x17B8
    x"01",x"23",x"9E",x"FD",x"7E",x"02",x"23",x"9E", -- 0x17C0
    x"FD",x"7E",x"03",x"23",x"9E",x"D2",x"8B",x"19", -- 0x17C8
    x"FD",x"7E",x"00",x"E6",x"0F",x"20",x"3B",x"FD", -- 0x17D0
    x"21",x"0A",x"00",x"FD",x"39",x"FD",x"4E",x"00", -- 0x17D8
    x"FD",x"46",x"01",x"FD",x"5E",x"02",x"FD",x"56", -- 0x17E0
    x"03",x"FD",x"34",x"00",x"20",x"0D",x"FD",x"34", -- 0x17E8
    x"01",x"20",x"08",x"FD",x"34",x"02",x"20",x"03", -- 0x17F0
    x"FD",x"34",x"03",x"21",x"2E",x"60",x"E5",x"D5", -- 0x17F8
    x"C5",x"CD",x"A4",x"0B",x"F1",x"F1",x"F1",x"21", -- 0x1800
    x"1E",x"00",x"39",x"36",x"2E",x"23",x"36",x"60", -- 0x1808
    x"18",x"0C",x"21",x"1E",x"00",x"39",x"7E",x"C6", -- 0x1810
    x"20",x"77",x"30",x"02",x"23",x"34",x"FD",x"21", -- 0x1818
    x"1E",x"00",x"FD",x"39",x"FD",x"6E",x"00",x"FD", -- 0x1820
    x"66",x"01",x"7E",x"B7",x"CA",x"6D",x"19",x"D6", -- 0x1828
    x"E5",x"CA",x"6D",x"19",x"FD",x"6E",x"00",x"FD", -- 0x1830
    x"66",x"01",x"11",x"0B",x"00",x"19",x"7E",x"E6", -- 0x1838
    x"18",x"C2",x"6D",x"19",x"21",x"0B",x"00",x"E5", -- 0x1840
    x"21",x"26",x"00",x"39",x"4E",x"23",x"46",x"C5", -- 0x1848
    x"21",x"22",x"00",x"39",x"4E",x"23",x"46",x"C5", -- 0x1850
    x"CD",x"F2",x"0D",x"F1",x"F1",x"F1",x"7C",x"B5", -- 0x1858
    x"C2",x"6D",x"19",x"21",x"22",x"00",x"39",x"7E", -- 0x1860
    x"FD",x"21",x"08",x"00",x"FD",x"39",x"FD",x"77", -- 0x1868
    x"00",x"21",x"23",x"00",x"39",x"7E",x"FD",x"21", -- 0x1870
    x"08",x"00",x"FD",x"39",x"FD",x"77",x"01",x"21", -- 0x1878
    x"06",x"00",x"39",x"FD",x"7E",x"00",x"C6",x"04", -- 0x1880
    x"77",x"FD",x"7E",x"01",x"CE",x"00",x"23",x"77", -- 0x1888
    x"21",x"1E",x"00",x"39",x"7E",x"23",x"66",x"6F", -- 0x1890
    x"11",x"1C",x"00",x"19",x"4E",x"23",x"46",x"23", -- 0x1898
    x"5E",x"23",x"56",x"21",x"06",x"00",x"39",x"7E", -- 0x18A0
    x"23",x"66",x"6F",x"71",x"23",x"70",x"23",x"73", -- 0x18A8
    x"23",x"72",x"21",x"06",x"00",x"39",x"FD",x"21", -- 0x18B0
    x"08",x"00",x"FD",x"39",x"FD",x"7E",x"00",x"C6", -- 0x18B8
    x"08",x"77",x"FD",x"7E",x"01",x"CE",x"00",x"23", -- 0x18C0
    x"77",x"21",x"1E",x"00",x"39",x"7E",x"23",x"66", -- 0x18C8
    x"6F",x"11",x"1A",x"00",x"19",x"7E",x"FD",x"21", -- 0x18D0
    x"04",x"00",x"FD",x"39",x"FD",x"77",x"00",x"23", -- 0x18D8
    x"7E",x"FD",x"77",x"01",x"FD",x"21",x"06",x"60", -- 0x18E0
    x"FD",x"7E",x"01",x"FD",x"B6",x"00",x"28",x"28", -- 0x18E8
    x"21",x"1E",x"00",x"39",x"7E",x"23",x"66",x"6F", -- 0x18F0
    x"11",x"14",x"00",x"19",x"4E",x"23",x"7E",x"E6", -- 0x18F8
    x"0F",x"47",x"FD",x"21",x"00",x"00",x"FD",x"39", -- 0x1900
    x"FD",x"71",x"02",x"FD",x"70",x"03",x"FD",x"36", -- 0x1908
    x"00",x"00",x"FD",x"36",x"01",x"00",x"18",x"13", -- 0x1910
    x"AF",x"FD",x"21",x"00",x"00",x"FD",x"39",x"FD", -- 0x1918
    x"77",x"00",x"FD",x"77",x"01",x"FD",x"77",x"02", -- 0x1920
    x"FD",x"77",x"03",x"21",x"04",x"00",x"39",x"4E", -- 0x1928
    x"23",x"46",x"11",x"00",x"00",x"79",x"21",x"00", -- 0x1930
    x"00",x"39",x"86",x"4F",x"78",x"23",x"8E",x"47", -- 0x1938
    x"7B",x"23",x"8E",x"5F",x"7A",x"23",x"8E",x"57", -- 0x1940
    x"21",x"06",x"00",x"39",x"7E",x"23",x"66",x"6F", -- 0x1948
    x"71",x"23",x"70",x"23",x"73",x"23",x"72",x"21", -- 0x1950
    x"08",x"00",x"39",x"7E",x"23",x"66",x"6F",x"AF", -- 0x1958
    x"77",x"23",x"77",x"23",x"77",x"23",x"36",x"00", -- 0x1960
    x"2E",x"01",x"C3",x"3F",x"1A",x"FD",x"21",x"16", -- 0x1968
    x"00",x"FD",x"39",x"FD",x"34",x"00",x"C2",x"B0", -- 0x1970
    x"17",x"FD",x"34",x"01",x"C2",x"B0",x"17",x"FD", -- 0x1978
    x"34",x"02",x"C2",x"B0",x"17",x"FD",x"34",x"03", -- 0x1980
    x"C3",x"B0",x"17",x"FD",x"21",x"06",x"60",x"FD", -- 0x1988
    x"7E",x"01",x"FD",x"B6",x"00",x"CA",x"3D",x"1A", -- 0x1990
    x"FD",x"21",x"1A",x"00",x"FD",x"39",x"FD",x"6E", -- 0x1998
    x"02",x"FD",x"66",x"03",x"E5",x"FD",x"6E",x"00", -- 0x19A0
    x"FD",x"66",x"01",x"E5",x"CD",x"80",x"0C",x"F1", -- 0x19A8
    x"F1",x"FD",x"21",x"1A",x"00",x"FD",x"39",x"FD", -- 0x19B0
    x"75",x"00",x"FD",x"74",x"01",x"FD",x"73",x"02", -- 0x19B8
    x"FD",x"72",x"03",x"FD",x"7E",x"00",x"E6",x"F8", -- 0x19C0
    x"4F",x"FD",x"46",x"01",x"FD",x"5E",x"02",x"FD", -- 0x19C8
    x"7E",x"03",x"E6",x"0F",x"57",x"79",x"D6",x"F8", -- 0x19D0
    x"20",x"0B",x"04",x"20",x"08",x"1C",x"20",x"05", -- 0x19D8
    x"7A",x"D6",x"0F",x"28",x"58",x"FD",x"7E",x"00", -- 0x19E0
    x"C6",x"FE",x"4F",x"FD",x"7E",x"01",x"CE",x"FF", -- 0x19E8
    x"47",x"FD",x"7E",x"02",x"CE",x"FF",x"5F",x"FD", -- 0x19F0
    x"7E",x"03",x"CE",x"FF",x"57",x"D5",x"C5",x"2A", -- 0x19F8
    x"20",x"60",x"E5",x"2A",x"1E",x"60",x"E5",x"CD", -- 0x1A00
    x"FE",x"1B",x"F1",x"F1",x"F1",x"F1",x"4D",x"44", -- 0x1A08
    x"FD",x"21",x"0C",x"60",x"FD",x"7E",x"00",x"81", -- 0x1A10
    x"4F",x"FD",x"7E",x"01",x"88",x"47",x"FD",x"7E", -- 0x1A18
    x"02",x"8B",x"5F",x"FD",x"7E",x"03",x"8A",x"57", -- 0x1A20
    x"FD",x"21",x"0E",x"00",x"FD",x"39",x"FD",x"71", -- 0x1A28
    x"00",x"FD",x"70",x"01",x"FD",x"73",x"02",x"FD", -- 0x1A30
    x"72",x"03",x"C3",x"8F",x"17",x"2E",x"00",x"FD", -- 0x1A38
    x"21",x"20",x"00",x"FD",x"39",x"FD",x"F9",x"C9", -- 0x1A40
    x"21",x"F4",x"FF",x"39",x"F9",x"21",x"04",x"00", -- 0x1A48
    x"39",x"EB",x"21",x"0C",x"60",x"01",x"04",x"00", -- 0x1A50
    x"ED",x"B0",x"21",x"0E",x"00",x"39",x"7E",x"FD", -- 0x1A58
    x"21",x"02",x"00",x"FD",x"39",x"FD",x"77",x"00", -- 0x1A60
    x"21",x"0F",x"00",x"39",x"7E",x"FD",x"21",x"02", -- 0x1A68
    x"00",x"FD",x"39",x"FD",x"77",x"01",x"21",x"00", -- 0x1A70
    x"00",x"39",x"FD",x"7E",x"00",x"C6",x"08",x"77", -- 0x1A78
    x"FD",x"7E",x"01",x"CE",x"00",x"23",x"77",x"E1", -- 0x1A80
    x"E5",x"4E",x"23",x"46",x"23",x"5E",x"23",x"56", -- 0x1A88
    x"79",x"C6",x"FE",x"4F",x"78",x"CE",x"FF",x"47", -- 0x1A90
    x"7B",x"CE",x"FF",x"5F",x"7A",x"CE",x"FF",x"57", -- 0x1A98
    x"D5",x"C5",x"2A",x"20",x"60",x"E5",x"2A",x"1E", -- 0x1AA0
    x"60",x"E5",x"CD",x"FE",x"1B",x"F1",x"F1",x"F1", -- 0x1AA8
    x"F1",x"4D",x"44",x"FD",x"21",x"04",x"00",x"FD", -- 0x1AB0
    x"39",x"FD",x"7E",x"00",x"81",x"4F",x"FD",x"7E", -- 0x1AB8
    x"01",x"88",x"47",x"FD",x"7E",x"02",x"8B",x"5F", -- 0x1AC0
    x"FD",x"7E",x"03",x"8A",x"57",x"FD",x"21",x"08", -- 0x1AC8
    x"00",x"FD",x"39",x"FD",x"71",x"00",x"FD",x"70", -- 0x1AD0
    x"01",x"FD",x"73",x"02",x"FD",x"72",x"03",x"21", -- 0x1AD8
    x"02",x"00",x"39",x"7E",x"23",x"66",x"6F",x"4E", -- 0x1AE0
    x"23",x"46",x"23",x"5E",x"23",x"56",x"79",x"FD", -- 0x1AE8
    x"21",x"22",x"60",x"FD",x"A6",x"00",x"4F",x"78", -- 0x1AF0
    x"FD",x"A6",x"01",x"47",x"7B",x"FD",x"A6",x"02", -- 0x1AF8
    x"5F",x"7A",x"FD",x"A6",x"03",x"57",x"FD",x"21", -- 0x1B00
    x"08",x"00",x"FD",x"39",x"FD",x"7E",x"00",x"81", -- 0x1B08
    x"4F",x"FD",x"7E",x"01",x"88",x"47",x"FD",x"7E", -- 0x1B10
    x"02",x"8B",x"5F",x"FD",x"7E",x"03",x"8A",x"57", -- 0x1B18
    x"21",x"10",x"00",x"39",x"7E",x"23",x"66",x"6F", -- 0x1B20
    x"E5",x"D5",x"C5",x"CD",x"A4",x"0B",x"F1",x"F1", -- 0x1B28
    x"F1",x"7D",x"B7",x"20",x"08",x"3E",x"FF",x"D3", -- 0x1B30
    x"50",x"2E",x"00",x"18",x"64",x"FD",x"21",x"02", -- 0x1B38
    x"00",x"FD",x"39",x"FD",x"6E",x"00",x"FD",x"66", -- 0x1B40
    x"01",x"4E",x"23",x"46",x"23",x"5E",x"23",x"56", -- 0x1B48
    x"0C",x"20",x"04",x"04",x"20",x"01",x"13",x"FD", -- 0x1B50
    x"6E",x"00",x"FD",x"66",x"01",x"71",x"23",x"70", -- 0x1B58
    x"23",x"73",x"23",x"72",x"79",x"FD",x"21",x"22", -- 0x1B60
    x"60",x"FD",x"A6",x"00",x"4F",x"78",x"FD",x"A6", -- 0x1B68
    x"01",x"47",x"7B",x"FD",x"A6",x"02",x"5F",x"7A", -- 0x1B70
    x"FD",x"A6",x"03",x"B3",x"B0",x"B1",x"20",x"1B", -- 0x1B78
    x"E1",x"E5",x"4E",x"23",x"46",x"23",x"5E",x"23", -- 0x1B80
    x"56",x"D5",x"C5",x"CD",x"80",x"0C",x"F1",x"F1", -- 0x1B88
    x"4D",x"44",x"E1",x"E5",x"71",x"23",x"70",x"23", -- 0x1B90
    x"73",x"23",x"72",x"3E",x"FF",x"D3",x"50",x"2E", -- 0x1B98
    x"01",x"FD",x"21",x"0C",x"00",x"FD",x"39",x"FD", -- 0x1BA0
    x"F9",x"C9",x"DD",x"E5",x"DD",x"21",x"00",x"00", -- 0x1BA8
    x"DD",x"39",x"DD",x"5E",x"04",x"DD",x"56",x"05", -- 0x1BB0
    x"1A",x"B7",x"28",x"03",x"13",x"18",x"F9",x"DD", -- 0x1BB8
    x"4E",x"06",x"DD",x"46",x"07",x"0A",x"03",x"12", -- 0x1BC0
    x"13",x"B7",x"20",x"F9",x"DD",x"6E",x"04",x"DD", -- 0x1BC8
    x"66",x"05",x"DD",x"E1",x"C9",x"C1",x"E1",x"E5", -- 0x1BD0
    x"C5",x"AF",x"47",x"4F",x"ED",x"B1",x"21",x"FF", -- 0x1BD8
    x"FF",x"ED",x"42",x"C9",x"F1",x"C1",x"D1",x"D5", -- 0x1BE0
    x"C5",x"F5",x"AF",x"6F",x"B0",x"06",x"10",x"20", -- 0x1BE8
    x"04",x"06",x"08",x"79",x"29",x"CB",x"11",x"17", -- 0x1BF0
    x"30",x"01",x"19",x"10",x"F7",x"C9",x"DD",x"E5", -- 0x1BF8
    x"DD",x"21",x"00",x"00",x"DD",x"39",x"21",x"FA", -- 0x1C00
    x"FF",x"39",x"F9",x"21",x"0A",x"00",x"39",x"4D", -- 0x1C08
    x"44",x"59",x"50",x"13",x"13",x"DD",x"73",x"FE", -- 0x1C10
    x"DD",x"72",x"FF",x"69",x"60",x"23",x"23",x"5E", -- 0x1C18
    x"23",x"56",x"21",x"0E",x"00",x"39",x"DD",x"75", -- 0x1C20
    x"FC",x"DD",x"74",x"FD",x"7E",x"23",x"66",x"6F", -- 0x1C28
    x"C5",x"E5",x"D5",x"CD",x"E4",x"1B",x"F1",x"F1", -- 0x1C30
    x"EB",x"C1",x"DD",x"6E",x"FE",x"DD",x"66",x"FF", -- 0x1C38
    x"73",x"23",x"72",x"59",x"50",x"13",x"13",x"DD", -- 0x1C40
    x"73",x"FE",x"DD",x"72",x"FF",x"69",x"60",x"23", -- 0x1C48
    x"23",x"5E",x"23",x"56",x"DD",x"6E",x"FC",x"DD", -- 0x1C50
    x"66",x"FD",x"23",x"23",x"7E",x"DD",x"77",x"FA", -- 0x1C58
    x"23",x"7E",x"DD",x"77",x"FB",x"69",x"60",x"7E", -- 0x1C60
    x"23",x"66",x"6F",x"C5",x"D5",x"E5",x"DD",x"6E", -- 0x1C68
    x"FA",x"DD",x"66",x"FB",x"E5",x"CD",x"E4",x"1B", -- 0x1C70
    x"F1",x"F1",x"D1",x"C1",x"19",x"EB",x"DD",x"6E", -- 0x1C78
    x"FE",x"DD",x"66",x"FF",x"73",x"23",x"72",x"59", -- 0x1C80
    x"50",x"13",x"13",x"33",x"33",x"D5",x"69",x"60", -- 0x1C88
    x"23",x"23",x"5E",x"23",x"56",x"69",x"60",x"23", -- 0x1C90
    x"7E",x"DD",x"77",x"FE",x"DD",x"6E",x"FC",x"DD", -- 0x1C98
    x"66",x"FD",x"23",x"66",x"D5",x"C5",x"DD",x"5E", -- 0x1CA0
    x"FE",x"2E",x"00",x"55",x"06",x"08",x"29",x"30", -- 0x1CA8
    x"01",x"19",x"10",x"FA",x"C1",x"D1",x"19",x"EB", -- 0x1CB0
    x"E1",x"E5",x"73",x"23",x"72",x"D1",x"E1",x"E5", -- 0x1CB8
    x"D5",x"5E",x"69",x"60",x"23",x"66",x"C5",x"2E", -- 0x1CC0
    x"00",x"55",x"06",x"08",x"29",x"30",x"01",x"19", -- 0x1CC8
    x"10",x"FA",x"C1",x"EB",x"DD",x"6E",x"FC",x"DD", -- 0x1CD0
    x"66",x"FD",x"23",x"E5",x"FD",x"E1",x"69",x"60", -- 0x1CD8
    x"7E",x"DD",x"77",x"FA",x"DD",x"6E",x"FC",x"DD", -- 0x1CE0
    x"66",x"FD",x"23",x"7E",x"D5",x"C5",x"5F",x"DD", -- 0x1CE8
    x"66",x"FA",x"2E",x"00",x"55",x"06",x"08",x"29", -- 0x1CF0
    x"30",x"01",x"19",x"10",x"FA",x"C1",x"D1",x"FD", -- 0x1CF8
    x"75",x"00",x"FD",x"74",x"01",x"DD",x"6E",x"FC", -- 0x1D00
    x"DD",x"66",x"FD",x"23",x"23",x"23",x"E3",x"DD", -- 0x1D08
    x"6E",x"FC",x"DD",x"66",x"FD",x"23",x"E5",x"FD", -- 0x1D10
    x"E1",x"DD",x"6E",x"FC",x"DD",x"66",x"FD",x"23", -- 0x1D18
    x"7E",x"23",x"66",x"6F",x"19",x"FD",x"75",x"00", -- 0x1D20
    x"FD",x"74",x"01",x"BF",x"ED",x"52",x"3E",x"00", -- 0x1D28
    x"17",x"E1",x"E5",x"77",x"59",x"50",x"0A",x"4F", -- 0x1D30
    x"DD",x"6E",x"FC",x"DD",x"66",x"FD",x"66",x"D5", -- 0x1D38
    x"59",x"2E",x"00",x"55",x"06",x"08",x"29",x"30", -- 0x1D40
    x"01",x"19",x"10",x"FA",x"D1",x"4D",x"44",x"79", -- 0x1D48
    x"12",x"13",x"78",x"12",x"D1",x"C1",x"C5",x"D5", -- 0x1D50
    x"AF",x"02",x"DD",x"7E",x"04",x"DD",x"86",x"08", -- 0x1D58
    x"6F",x"DD",x"7E",x"05",x"DD",x"8E",x"09",x"67", -- 0x1D60
    x"DD",x"7E",x"06",x"DD",x"8E",x"0A",x"5F",x"DD", -- 0x1D68
    x"7E",x"07",x"DD",x"8E",x"0B",x"57",x"DD",x"F9", -- 0x1D70
    x"DD",x"E1",x"C9",x"5E",x"05",x"01",x"02",x"00", -- 0x1D78
    x"78",x"B1",x"28",x"08",x"11",x"34",x"62",x"21", -- 0x1D80
    x"7B",x"1D",x"ED",x"B0",x"C9",x"FF",x"FF",x"FF", -- 0x1D88
    x"FF",x"FF",x"FF",x"FF",x"FF",x"FF",x"FF",x"FF", -- 0x1D90
    x"FF",x"FF",x"FF",x"FF",x"FF",x"FF",x"FF",x"FF", -- 0x1D98
    x"FF",x"FF",x"FF",x"FF",x"FF",x"FF",x"FF",x"FF", -- 0x1DA0
    x"FF",x"FF",x"FF",x"FF",x"FF",x"FF",x"FF",x"FF", -- 0x1DA8
    x"FF",x"FF",x"FF",x"FF",x"FF",x"FF",x"FF",x"FF", -- 0x1DB0
    x"FF",x"FF",x"FF",x"FF",x"FF",x"FF",x"FF",x"FF", -- 0x1DB8
    x"FF",x"FF",x"FF",x"FF",x"FF",x"FF",x"FF",x"FF", -- 0x1DC0
    x"FF",x"FF",x"FF",x"FF",x"FF",x"FF",x"FF",x"FF", -- 0x1DC8
    x"FF",x"FF",x"FF",x"FF",x"FF",x"FF",x"FF",x"FF", -- 0x1DD0
    x"FF",x"FF",x"FF",x"FF",x"FF",x"FF",x"FF",x"FF", -- 0x1DD8
    x"FF",x"FF",x"FF",x"FF",x"FF",x"FF",x"FF",x"FF", -- 0x1DE0
    x"FF",x"FF",x"FF",x"FF",x"FF",x"FF",x"FF",x"FF", -- 0x1DE8
    x"FF",x"FF",x"FF",x"FF",x"FF",x"FF",x"FF",x"FF", -- 0x1DF0
    x"FF",x"FF",x"FF",x"FF",x"FF",x"FF",x"FF",x"FF", -- 0x1DF8
    x"FF",x"FF",x"FF",x"FF",x"FF",x"FF",x"FF",x"FF", -- 0x1E00
    x"FF",x"FF",x"FF",x"FF",x"FF",x"FF",x"FF",x"FF", -- 0x1E08
    x"FF",x"FF",x"FF",x"FF",x"FF",x"FF",x"FF",x"FF", -- 0x1E10
    x"FF",x"FF",x"FF",x"FF",x"FF",x"FF",x"FF",x"FF", -- 0x1E18
    x"FF",x"FF",x"FF",x"FF",x"FF",x"FF",x"FF",x"FF", -- 0x1E20
    x"FF",x"FF",x"FF",x"FF",x"FF",x"FF",x"FF",x"FF", -- 0x1E28
    x"FF",x"FF",x"FF",x"FF",x"FF",x"FF",x"FF",x"FF", -- 0x1E30
    x"FF",x"FF",x"FF",x"FF",x"FF",x"FF",x"FF",x"FF", -- 0x1E38
    x"FF",x"FF",x"FF",x"FF",x"FF",x"FF",x"FF",x"FF", -- 0x1E40
    x"FF",x"FF",x"FF",x"FF",x"FF",x"FF",x"FF",x"FF", -- 0x1E48
    x"FF",x"FF",x"FF",x"FF",x"FF",x"FF",x"FF",x"FF", -- 0x1E50
    x"FF",x"FF",x"FF",x"FF",x"FF",x"FF",x"FF",x"FF", -- 0x1E58
    x"FF",x"FF",x"FF",x"FF",x"FF",x"FF",x"FF",x"FF", -- 0x1E60
    x"FF",x"FF",x"FF",x"FF",x"FF",x"FF",x"FF",x"FF", -- 0x1E68
    x"FF",x"FF",x"FF",x"FF",x"FF",x"FF",x"FF",x"FF", -- 0x1E70
    x"FF",x"FF",x"FF",x"FF",x"FF",x"FF",x"FF",x"FF", -- 0x1E78
    x"FF",x"FF",x"FF",x"FF",x"FF",x"FF",x"FF",x"FF", -- 0x1E80
    x"FF",x"FF",x"FF",x"FF",x"FF",x"FF",x"FF",x"FF", -- 0x1E88
    x"FF",x"FF",x"FF",x"FF",x"FF",x"FF",x"FF",x"FF", -- 0x1E90
    x"FF",x"FF",x"FF",x"FF",x"FF",x"FF",x"FF",x"FF", -- 0x1E98
    x"FF",x"FF",x"FF",x"FF",x"FF",x"FF",x"FF",x"FF", -- 0x1EA0
    x"FF",x"FF",x"FF",x"FF",x"FF",x"FF",x"FF",x"FF", -- 0x1EA8
    x"FF",x"FF",x"FF",x"FF",x"FF",x"FF",x"FF",x"FF", -- 0x1EB0
    x"FF",x"FF",x"FF",x"FF",x"FF",x"FF",x"FF",x"FF", -- 0x1EB8
    x"FF",x"FF",x"FF",x"FF",x"FF",x"FF",x"FF",x"FF", -- 0x1EC0
    x"FF",x"FF",x"FF",x"FF",x"FF",x"FF",x"FF",x"FF", -- 0x1EC8
    x"FF",x"FF",x"FF",x"FF",x"FF",x"FF",x"FF",x"FF", -- 0x1ED0
    x"FF",x"FF",x"FF",x"FF",x"FF",x"FF",x"FF",x"FF", -- 0x1ED8
    x"FF",x"FF",x"FF",x"FF",x"FF",x"FF",x"FF",x"FF", -- 0x1EE0
    x"FF",x"FF",x"FF",x"FF",x"FF",x"FF",x"FF",x"FF", -- 0x1EE8
    x"FF",x"FF",x"FF",x"FF",x"FF",x"FF",x"FF",x"FF", -- 0x1EF0
    x"FF",x"FF",x"FF",x"FF",x"FF",x"FF",x"FF",x"FF", -- 0x1EF8
    x"FF",x"FF",x"FF",x"FF",x"FF",x"FF",x"FF",x"FF", -- 0x1F00
    x"FF",x"FF",x"FF",x"FF",x"FF",x"FF",x"FF",x"FF", -- 0x1F08
    x"FF",x"FF",x"FF",x"FF",x"FF",x"FF",x"FF",x"FF", -- 0x1F10
    x"FF",x"FF",x"FF",x"FF",x"FF",x"FF",x"FF",x"FF", -- 0x1F18
    x"FF",x"FF",x"FF",x"FF",x"FF",x"FF",x"FF",x"FF", -- 0x1F20
    x"FF",x"FF",x"FF",x"FF",x"FF",x"FF",x"FF",x"FF", -- 0x1F28
    x"FF",x"FF",x"FF",x"FF",x"FF",x"FF",x"FF",x"FF", -- 0x1F30
    x"FF",x"FF",x"FF",x"FF",x"FF",x"FF",x"FF",x"FF", -- 0x1F38
    x"FF",x"FF",x"FF",x"FF",x"FF",x"FF",x"FF",x"FF", -- 0x1F40
    x"FF",x"FF",x"FF",x"FF",x"FF",x"FF",x"FF",x"FF", -- 0x1F48
    x"FF",x"FF",x"FF",x"FF",x"FF",x"FF",x"FF",x"FF", -- 0x1F50
    x"FF",x"FF",x"FF",x"FF",x"FF",x"FF",x"FF",x"FF", -- 0x1F58
    x"FF",x"FF",x"FF",x"FF",x"FF",x"FF",x"FF",x"FF", -- 0x1F60
    x"FF",x"FF",x"FF",x"FF",x"FF",x"FF",x"FF",x"FF", -- 0x1F68
    x"FF",x"FF",x"FF",x"FF",x"FF",x"FF",x"FF",x"FF", -- 0x1F70
    x"FF",x"FF",x"FF",x"FF",x"FF",x"FF",x"FF",x"FF", -- 0x1F78
    x"FF",x"FF",x"FF",x"FF",x"FF",x"FF",x"FF",x"FF", -- 0x1F80
    x"FF",x"FF",x"FF",x"FF",x"FF",x"FF",x"FF",x"FF", -- 0x1F88
    x"FF",x"FF",x"FF",x"FF",x"FF",x"FF",x"FF",x"FF", -- 0x1F90
    x"FF",x"FF",x"FF",x"FF",x"FF",x"FF",x"FF",x"FF", -- 0x1F98
    x"FF",x"FF",x"FF",x"FF",x"FF",x"FF",x"FF",x"FF", -- 0x1FA0
    x"FF",x"FF",x"FF",x"FF",x"FF",x"FF",x"FF",x"FF", -- 0x1FA8
    x"FF",x"FF",x"FF",x"FF",x"FF",x"FF",x"FF",x"FF", -- 0x1FB0
    x"FF",x"FF",x"FF",x"FF",x"FF",x"FF",x"FF",x"FF", -- 0x1FB8
    x"FF",x"FF",x"FF",x"FF",x"FF",x"FF",x"FF",x"FF", -- 0x1FC0
    x"FF",x"FF",x"FF",x"FF",x"FF",x"FF",x"FF",x"FF", -- 0x1FC8
    x"FF",x"FF",x"FF",x"FF",x"FF",x"FF",x"FF",x"FF", -- 0x1FD0
    x"FF",x"FF",x"FF",x"FF",x"FF",x"FF",x"FF",x"FF", -- 0x1FD8
    x"FF",x"FF",x"FF",x"FF",x"FF",x"FF",x"FF",x"FF", -- 0x1FE0
    x"FF",x"FF",x"FF",x"FF",x"FF",x"FF",x"FF",x"FF", -- 0x1FE8
    x"FF",x"FF",x"FF",x"FF",x"FF",x"FF",x"FF",x"FF", -- 0x1FF0
    x"FF",x"FF",x"FF",x"FF",x"FF",x"FF",x"FF",x"FF"  -- 0x1FF8
  );

begin

  p_rom : process
  begin
    wait until rising_edge(CLK);
     DATA <= ROM(to_integer(unsigned(ADDR)));
  end process;
end RTL;
