fbelavenuto/colecofpga/(commit log)

2016-08-15 Upload inicial
    [Mini_EP2C5_prot1.xlsx]
2016-08-15 Modificado CPU para T80 do OCM, testar!! Acertado nome de alguns sinais
2016-08-18 Retirado componentes vdp alternativos por nao ser necessário mais. Adaptado tops para mudancas do colecovision.vhd
2016-09-05 Adicionado TOP para ZX-Uno, testar
2016-09-06 Adicionando suporte para ZX-Uno. Corrigido som, testar
    [colecovision.vhd, loaderrom.vhd, main.c, zxuno_top.vhd]
2016-09-07 Core pro ZX-Uno terminado. Re-ajustado timing do video. Acertado todos os TOPs. Corrigido bug no prot2, scandoubler nao mudava pois sinal estava sempre em reset.
    [colecovision.vhd, loaderrom.vhd, zxuno_top.vhd]
2016-09-08 Organizando arquivos
    [Mini_EP2C5_prot1.xlsx]
2016-09-09 Added Eagle project and documentation for the stand-alone prototype using chinese EP2C5 board.
    [colecovision2.brd, colecovision2.sch]
2016-09-14 Fixed bug in RAM: SuperCobra needs of 1K mirrored ram to work. (test) Added CTRL+ALT+BACKSPACE in ZX-Uno to reload Xilinx first core. (test)
    [zxuno_top.vhd]
2016-09-15 CTRL+ALT+BACKSPACE works! Multcart needs 8K RAM, then updated TOPs for supply 8K for Multcart and 1K for games. Tested. Sigma-delta DAC works better with resistor 2K2 and capacitor 10n. Updated prot2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
    [colecovision2.brd, colecovision2.sch]
2016-11-07 Trying add suport to SEGA joypad. Zipped SD files. Fixed Sprite bug > 28 in VDP18. Testing multicore board
    [colecovision.vhd, zxuno_top.vhd]
2016-11-07 Fixed RGB reversed in Multicore Board.
2016-11-21 Testing HDMI in Multicore Board
2016-11-21 More tuning. Fixed all tops
    [zxuno_top.vhd]
2017-03-15 Added TOP to ZX-Uno VGA 2M board
2017-03-23 Revert "Trying add external cartridge for ZX-Uno. To do tests."
    This reverts commit cd5c63e47669156af42d50eac05f2e3ad55956c8.
    [colecovision.vhd, loaderrom.vhd, main.c, zxuno_top.vhd]
2017-03-25 Fixed Multicore top. Adjusts in Multicart
    [main.c]
2017-03-25 Adding external cartridge support for ZX-Uno Fixed some bugs Clean-up
    [colecovision.vhd, loaderrom.vhd, main.c, zxuno_top.vhd, zxuno_top_vga2m.vhd]
2017-05-18 HDMI: fixed space, todo tests.
    [loaderrom.vhd, main.c, zxuno_top.vhd]
2017-05-18 Fixed mess with Loader caused by TortoiseSVN. VGA and HDMI working!
    [loaderrom.vhd, main.c]
2017-07-03 Added new board.
2017-07-04 Testing new board, some troubles to fix
2017-07-05 Added some xilinx packet data documentation.
    [ConfigPacket.txt]
2017-07-05 Adding internal BIOS to the cvuno board starts without SD Card. Todo tests.
2017-07-08 CVUNO: Pins 7 and 9 of joystick 1 are not supported, so the board has been changed to reroute those pins to the RESET and SD_CD signals. Reading I/O port 0x50 returns SD_CD flag and the loader reads 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
    [colecovision.vhd, loaderrom.vhd, main.c]
2022-06-11 Ajustes para sintetizar
